OldFORTRANdog/GST_Arduino_Robotics/Documentation/B3_Documentation_2024.pdf

# BreadBoardBot

# Layout and wiring, rev. 2024d

6/4/2024

# B3 Top Layout: 3 large holes, 2 medium holes

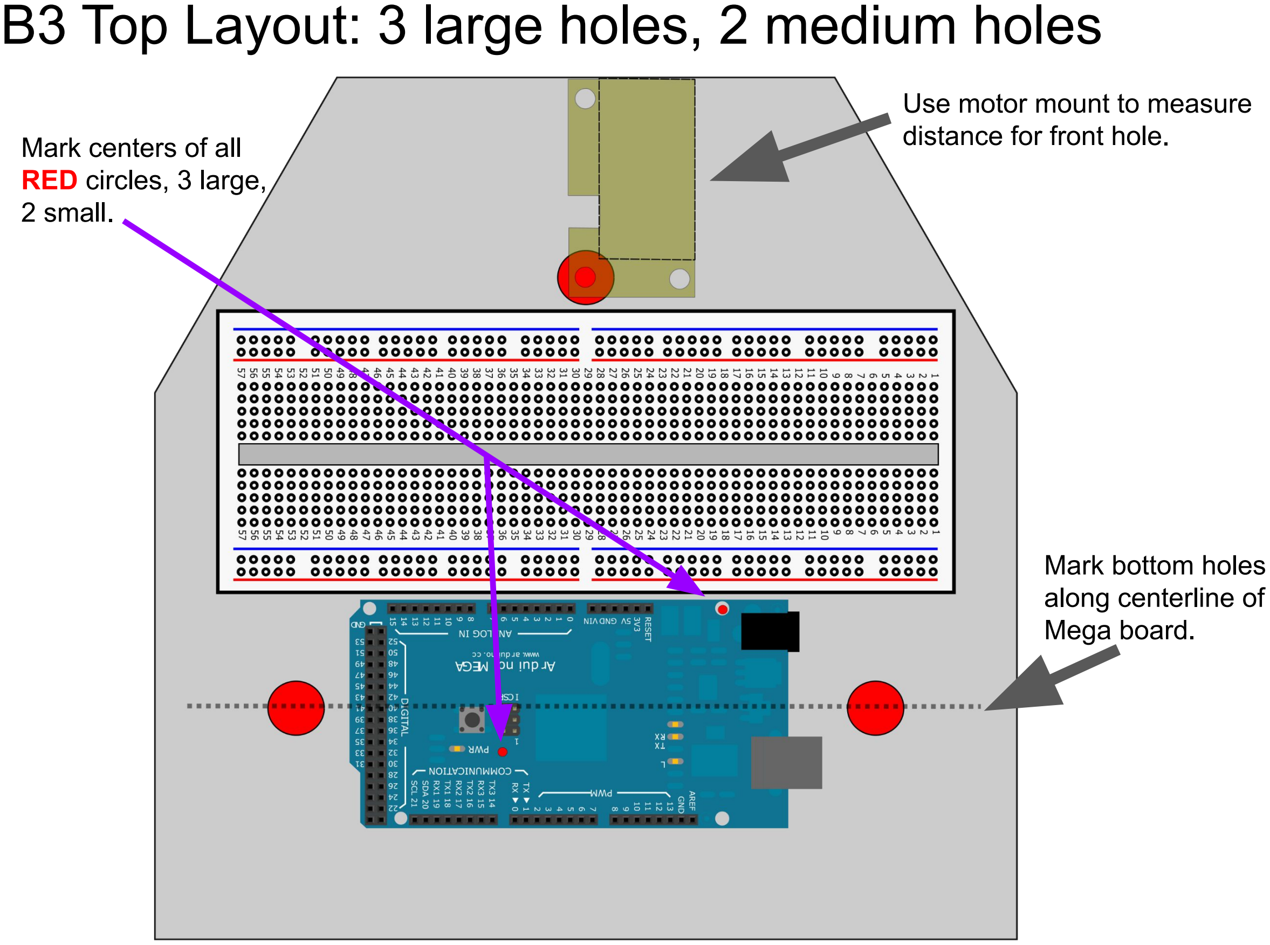
[picture p1: page 2]

| Use motor mount to measure distance for front hole.

Mark bottom holes
along centerline of
Mega board.

Mark centers of all
RED circles, 3 large,
2 small.

# B3 Bottom Layout 1: 6 medium holes, 4 small holes

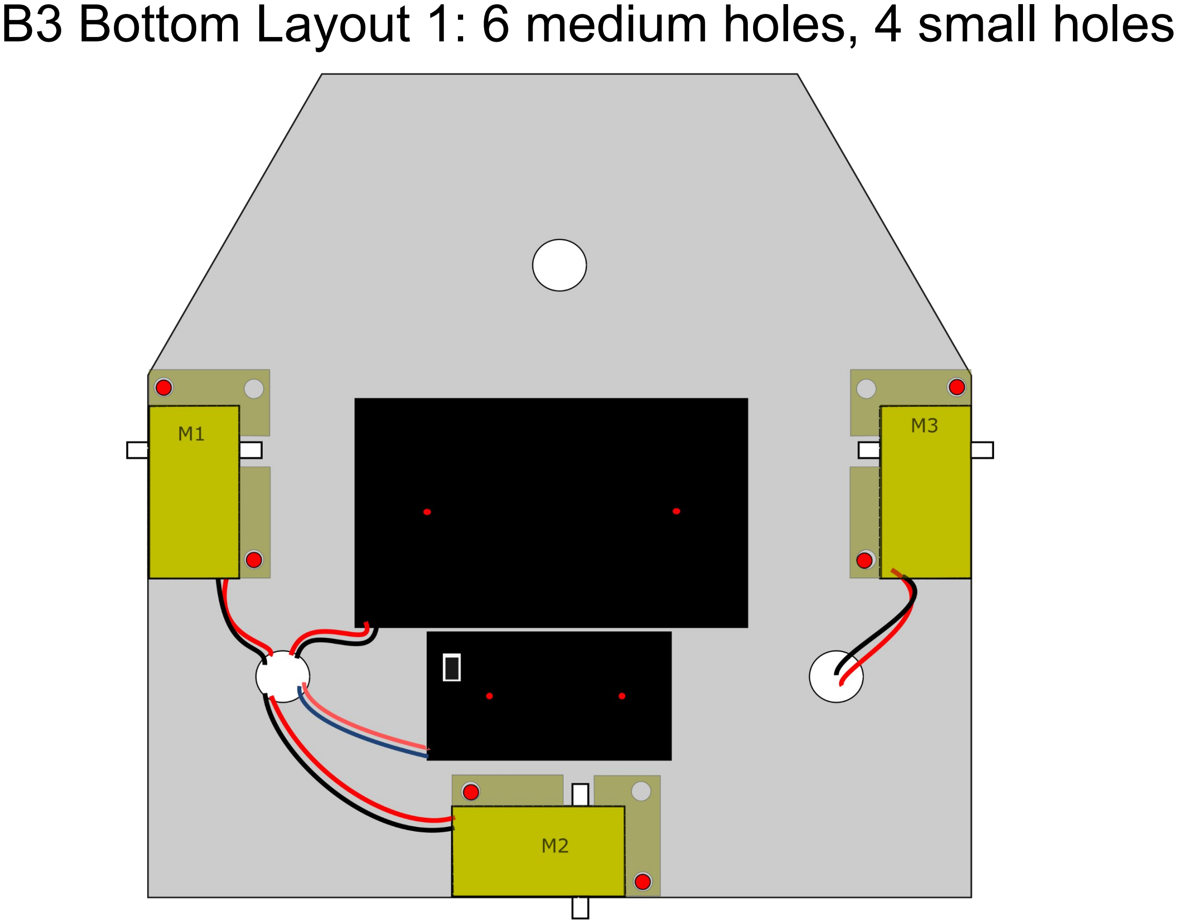
[picture p2: page 3]

# B3 Bottom Layout 2: 4 more medium holes

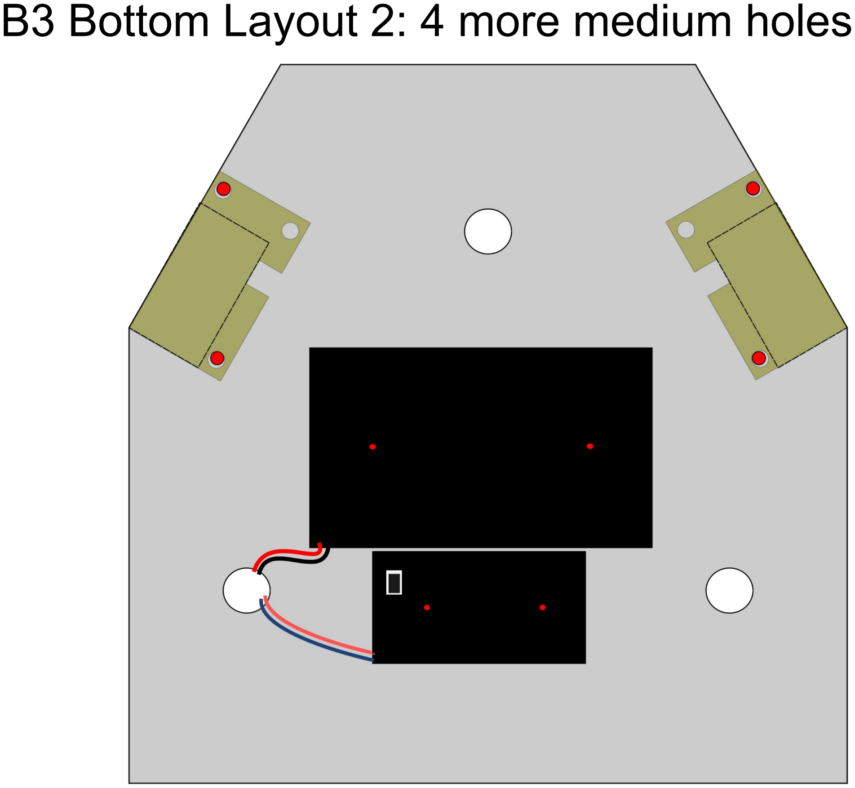
[picture p3: page 4]

Drill holes, then… | Omniwheel assembly (demo)
- Always wear safety glasses when
using the drills. This is
non-negotiable.
- Use medium sized bit for all motor mount holes (10 of those) and, HIGHLY SUGGESTED, to drill pilot holes for the ½” big holes (3 of those).
- Drill six small holes, 2 marked on front for the Mega, and 4 on the back for both battery holders.
- Drill the three big holes, which is much easier with pilot holes.
- Place motors into motor mounts. Make sure the stub on side of motor fits into hole on side of motor mounts.
- Using the small white tubes and the long small screws (3 of each, one set per motor), place the tube fully on the outside motor axle (the side away from the rim of the motor mount.)
- Drill small hole through axle and tube and secure tube in place with screw.
- Get omniwheels (3) and the largest screws. Put a small amount of hot glue on the tube, push omni wheel over tube, and screw large screw into tube to expand the tube and provide grip for the wheel.

# B3 Begin Assembly (shield demo)

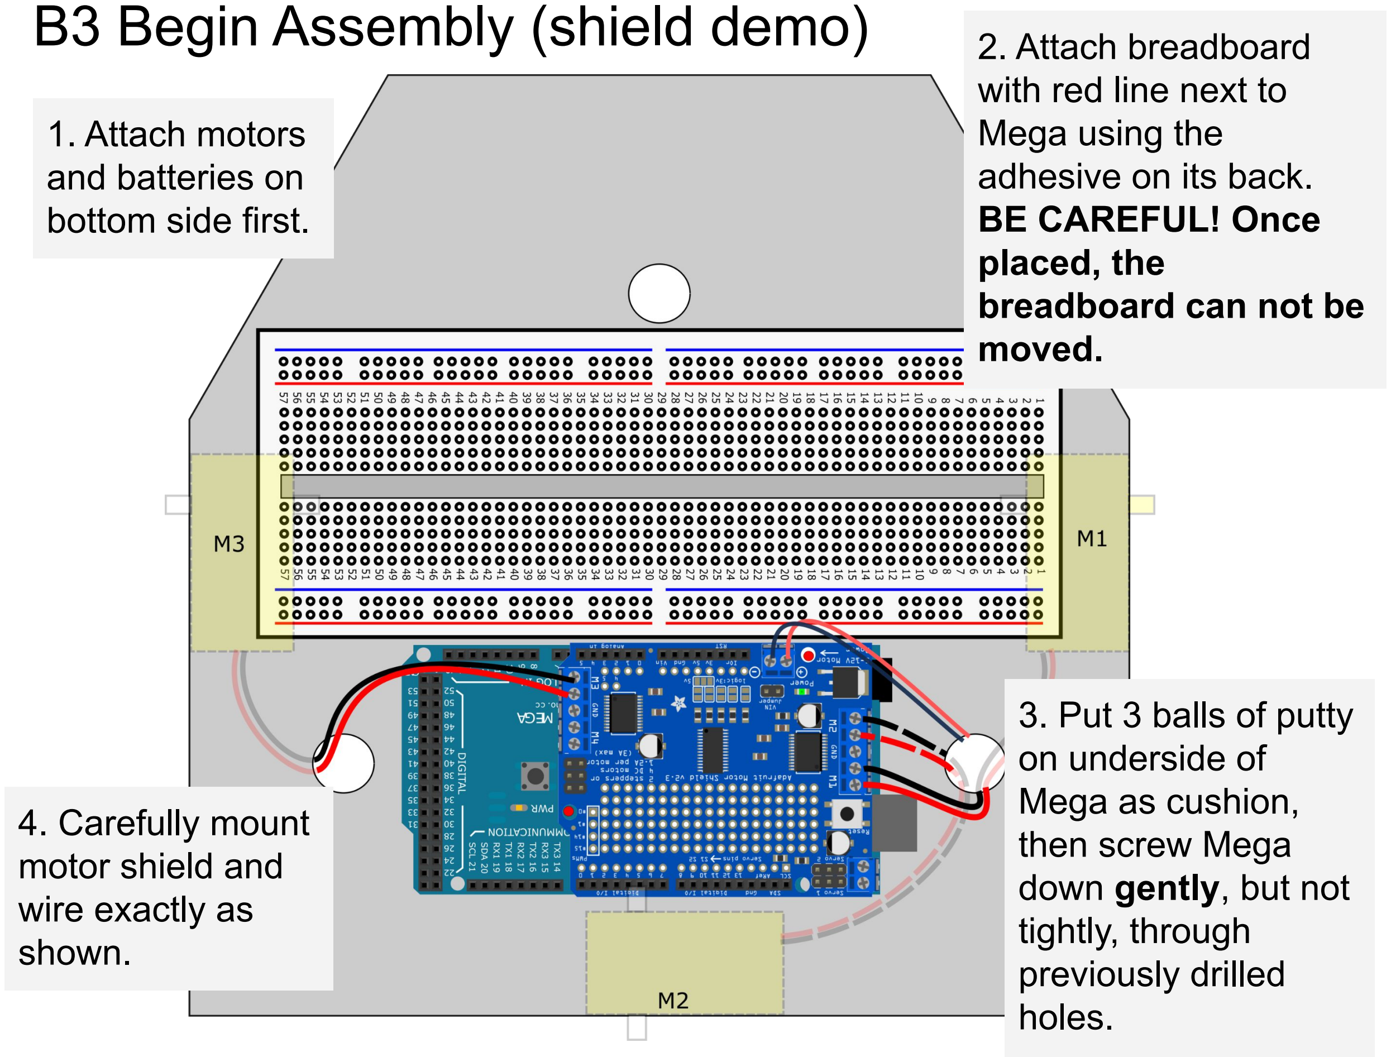
[picture p4: page 6]

1. Attach motors
and batteries on
bottom side first.
2. Attach breadboard
with red line next to
Mega using the
adhesive on its back.
BE CAREFUL! Once
placed, the
breadboard can not be
moved.
3. Put 3 balls of putty
on underside of
Mega as cushion,
then screw Mega
down gently, but not
tightly, through
previously drilled
holes.
4. Carefully mount
motor shield and
wire exactly as
shown.

# B3 Power and Ground Circuits

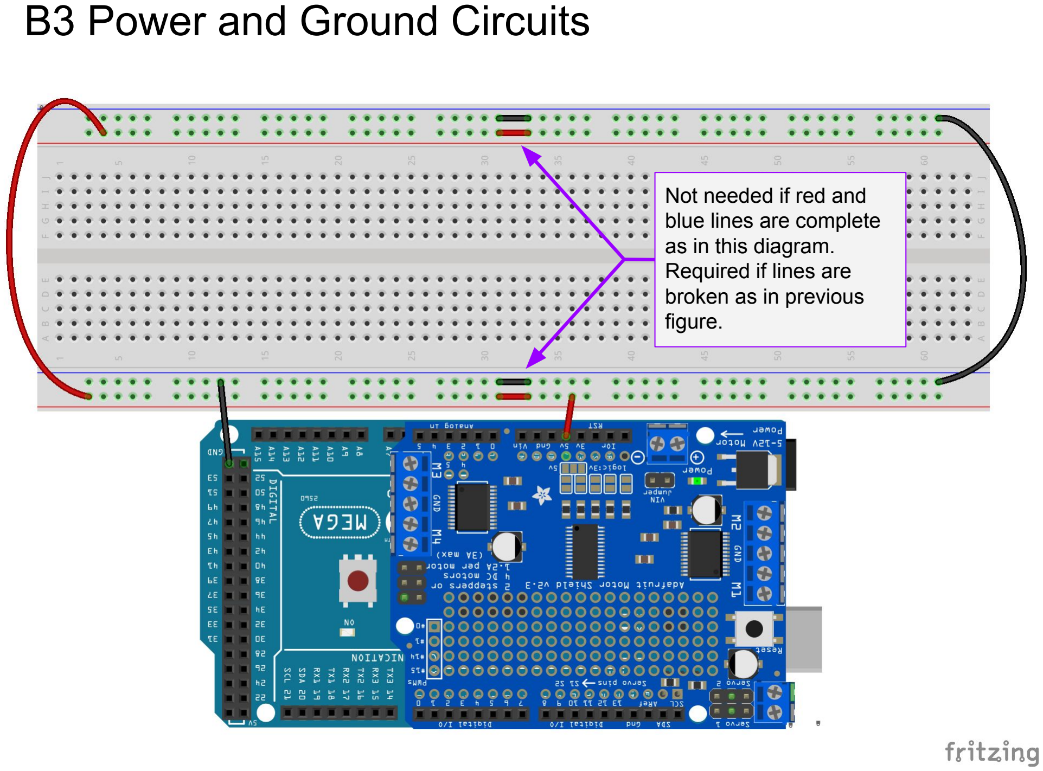
[picture p5: page 7]

Not needed if red and
blue lines are complete
as in this diagram.
Required if lines are
broken as in previous
figure.

# B3 Blink Circuits

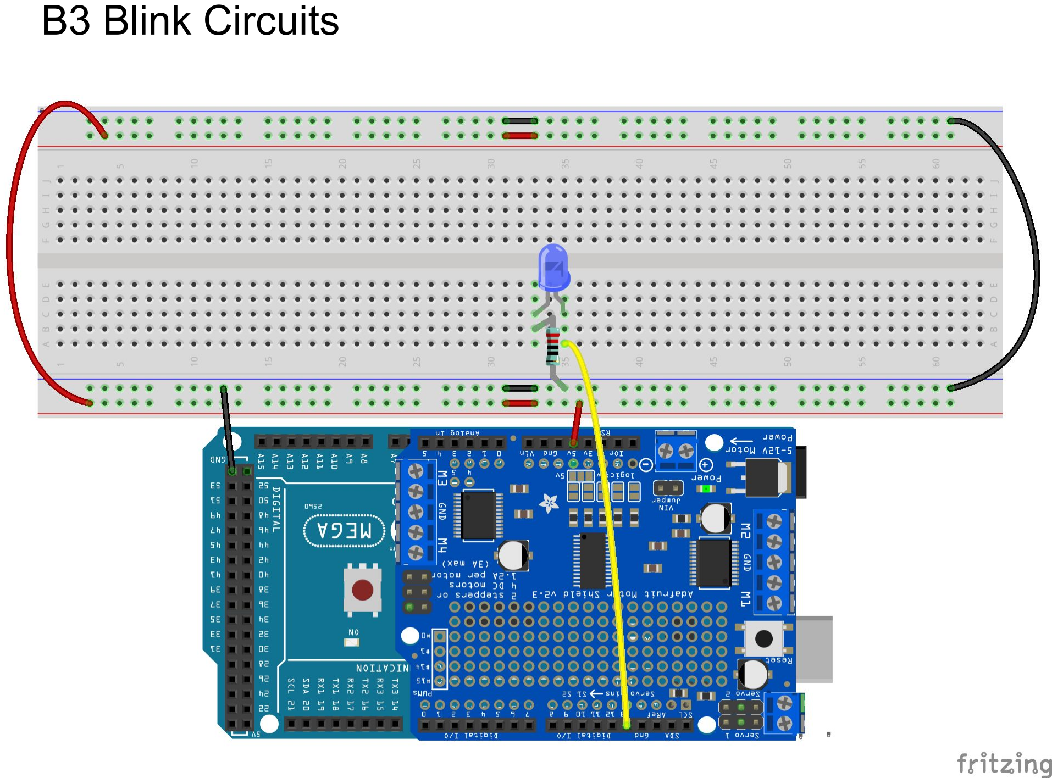
[picture p6: page 8]

# B3 Blink & Bump Circuits

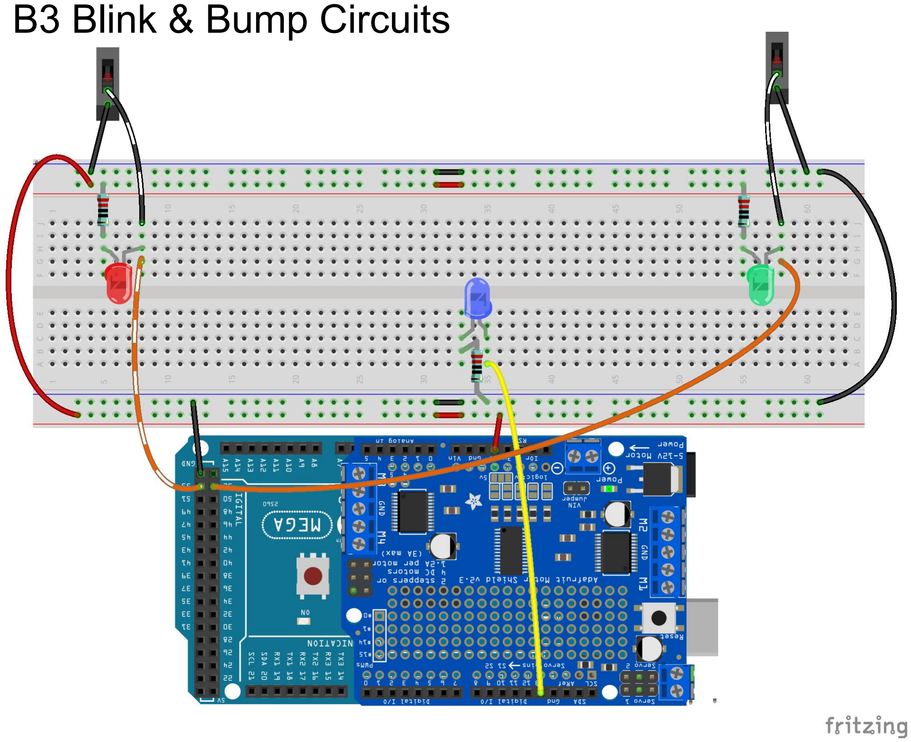
[picture p7: page 9]

# B3 Blink, Bump & Light Detection Circuits

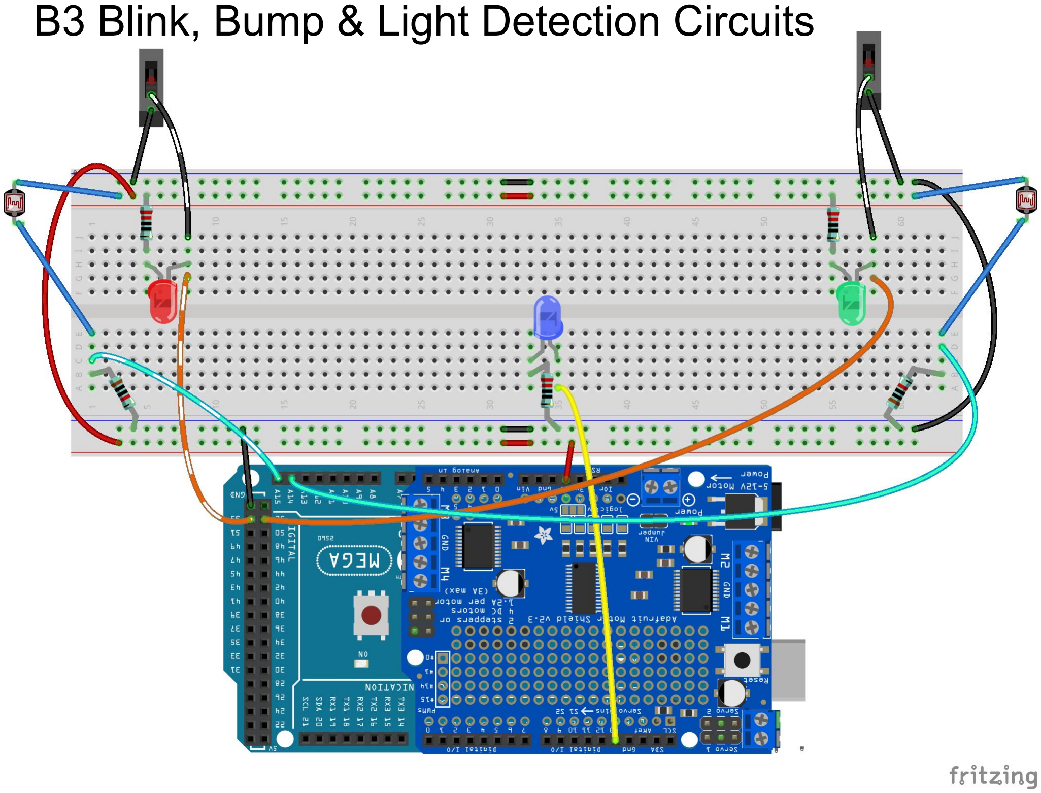
[picture p8: page 10]

# B3 Blink, Bump, Light & IR Circuits

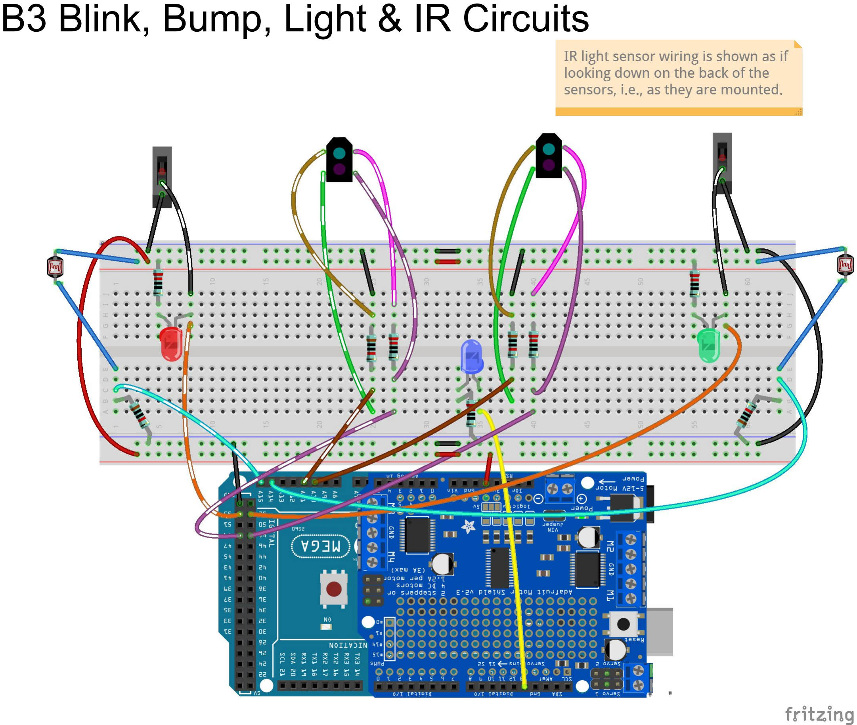
[picture p9: page 11]

# B3 Blink, Bump, Light, IR, Sonic & Servo Circuits

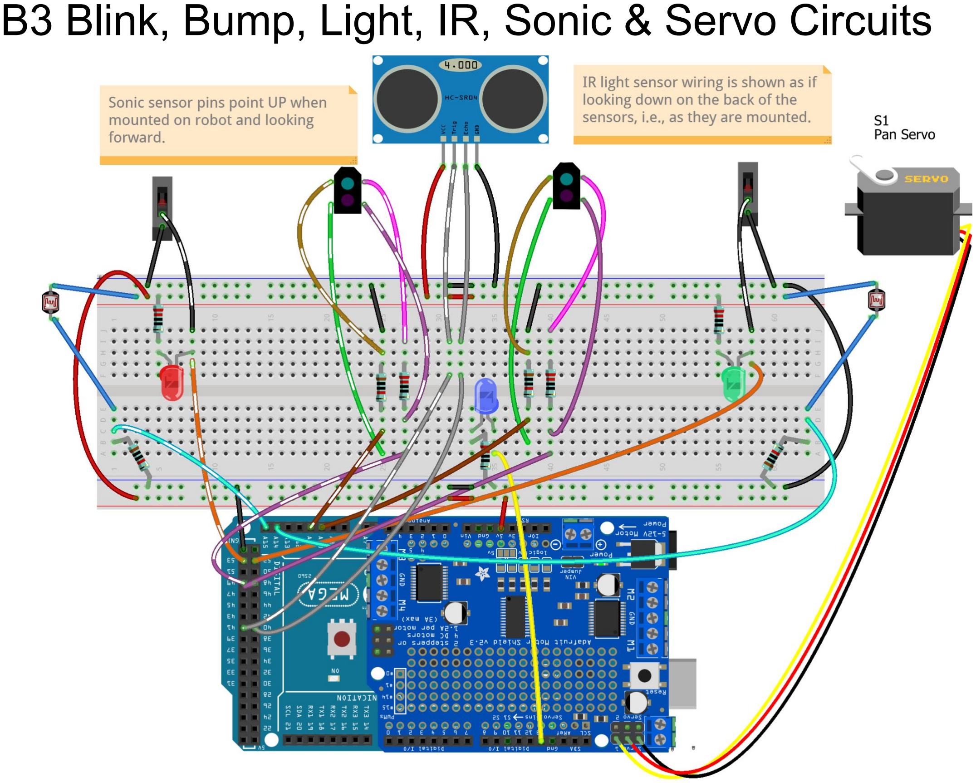
[picture p10: page 12]

# B3 Bonus Circuits

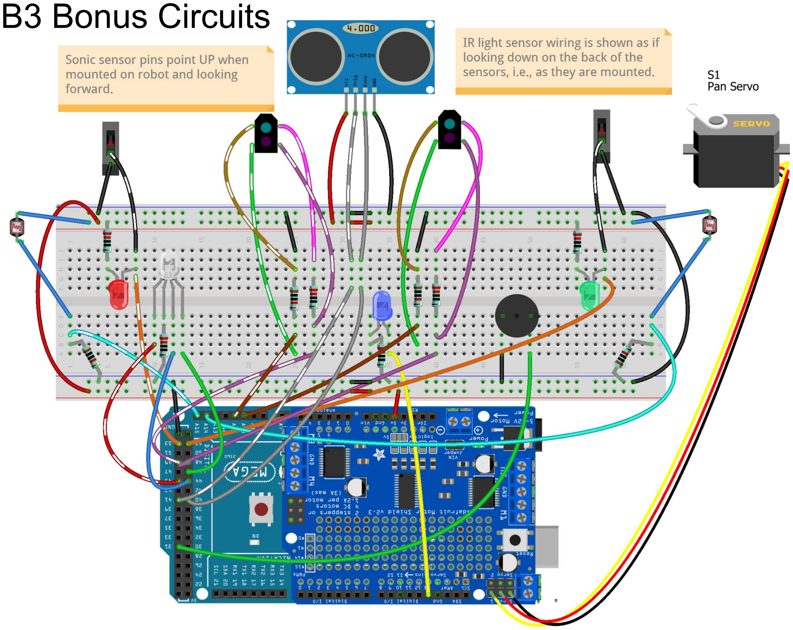
[picture p11: page 13]
