OldFORTRANdog/GST_Arduino_Robotics/2022GST/B3_Documentation_2022.pdf

# BreadBoardBot

Layout and wiring, 2022

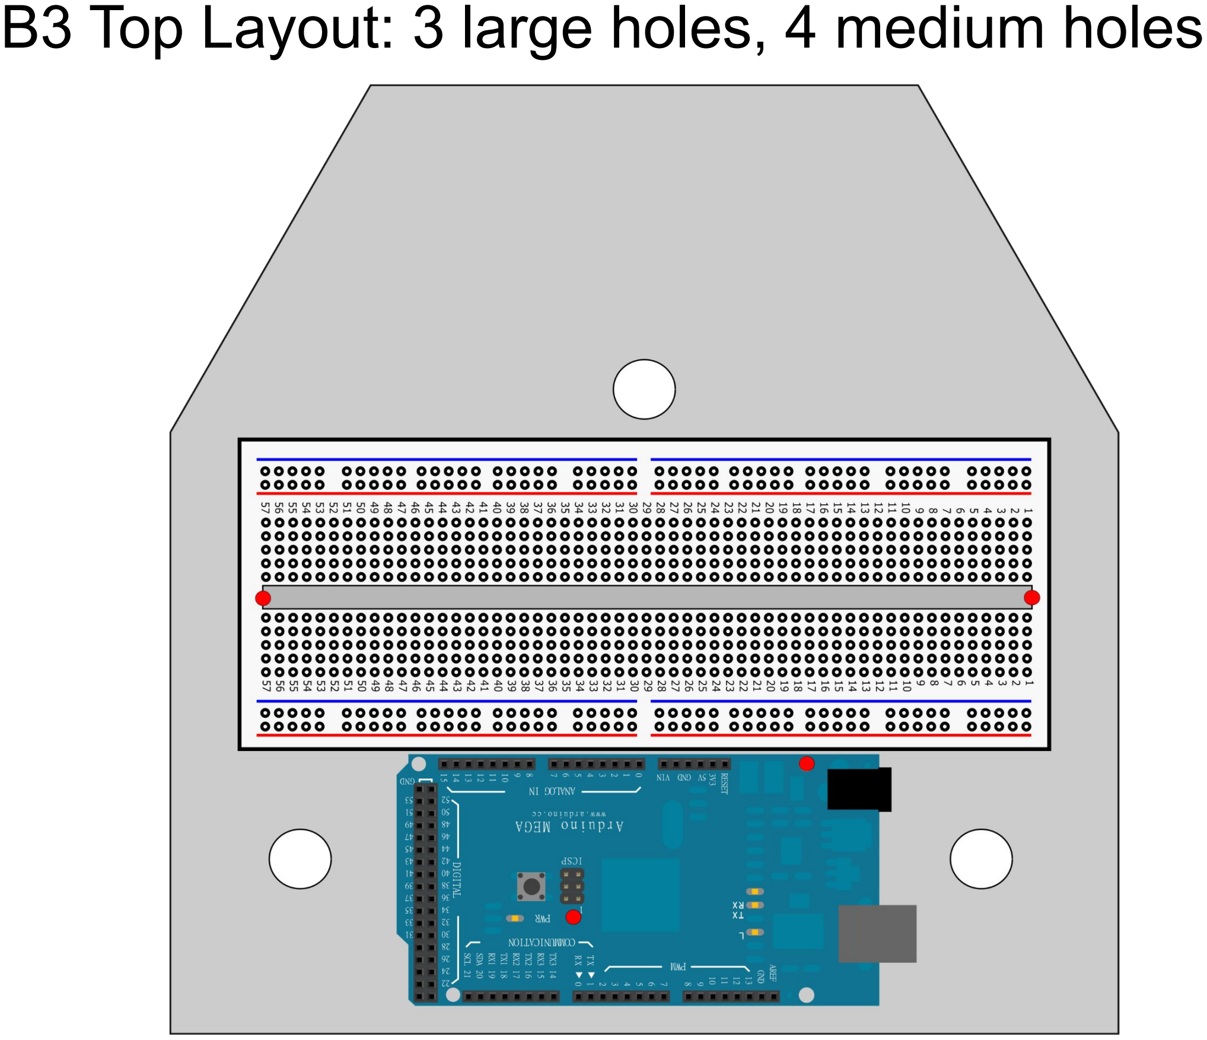
[picture p12: page 2]

B3 Top Layout: 3 large holes, 4 medium holes

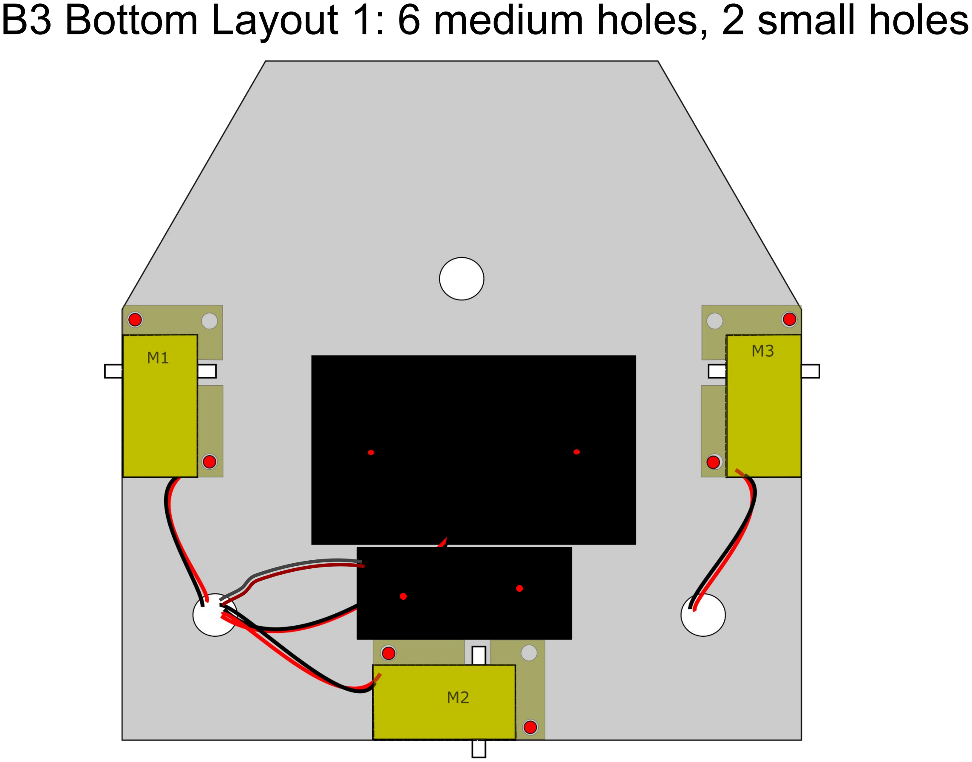
[picture p13: page 3]

B3 Bottom Layout 1: 6 medium holes, 2 small holes

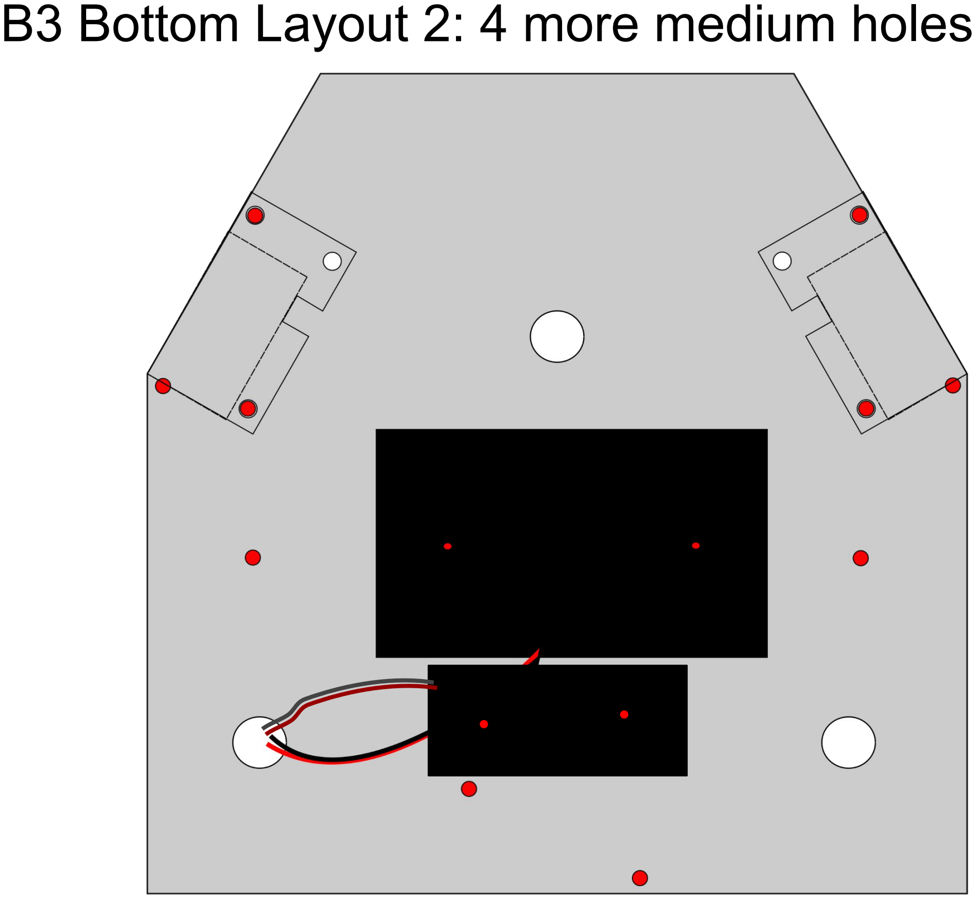
[picture p14: page 4]

B3 Bottom Layout 2: 4 more medium holes

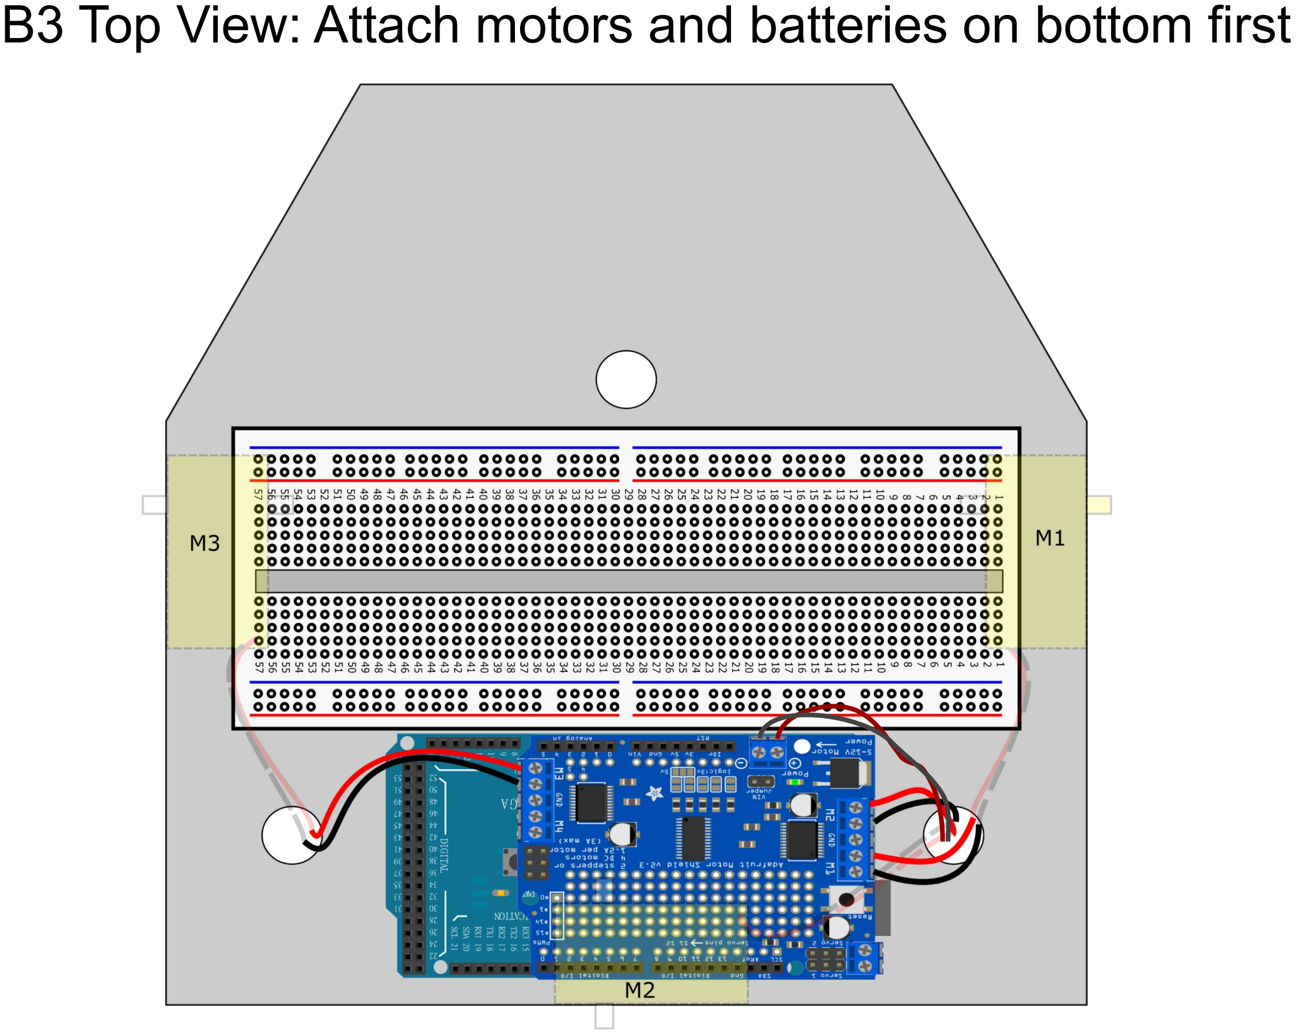
[picture p15: page 5]

B3 Top View: Attach motors and batteries on bottom first

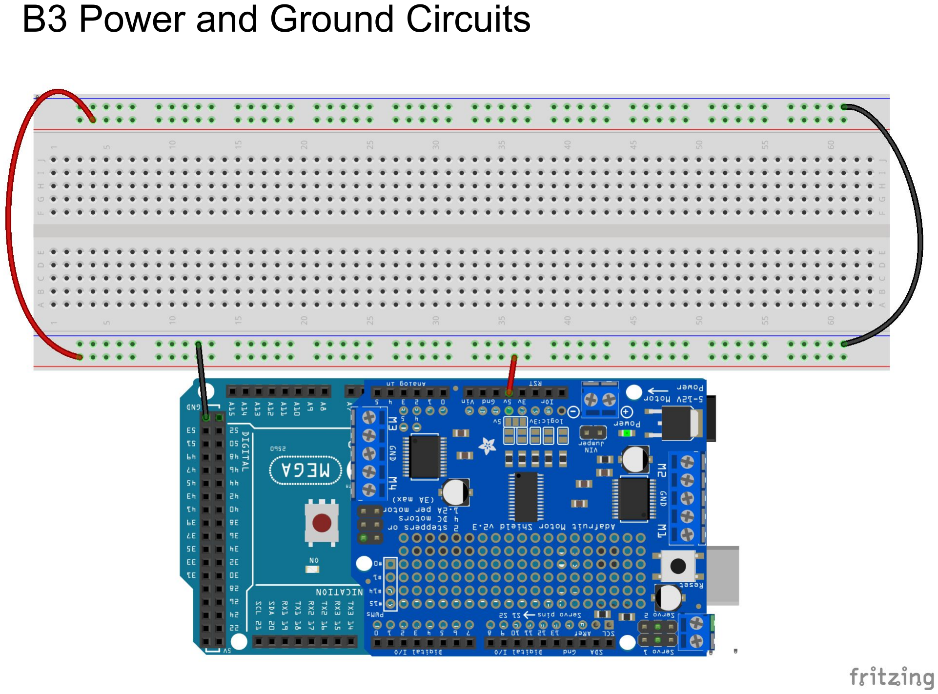
[picture p16: page 6]

B3 Power and Ground Circuits

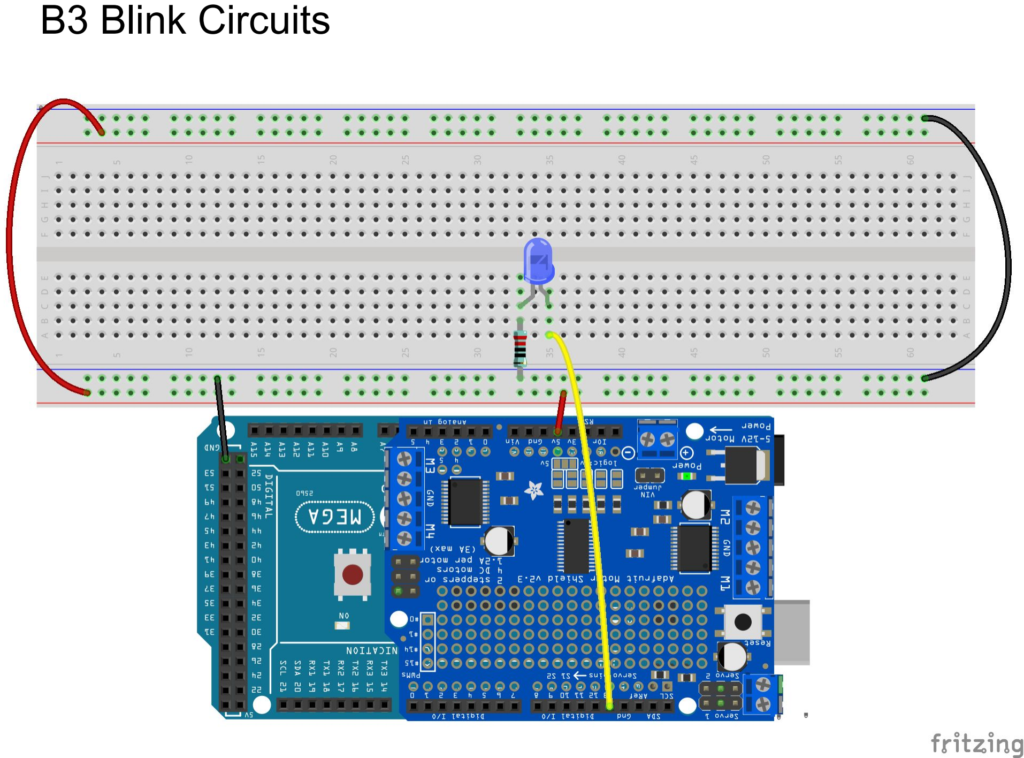
[picture p17: page 7]

B3 Blink Circuits

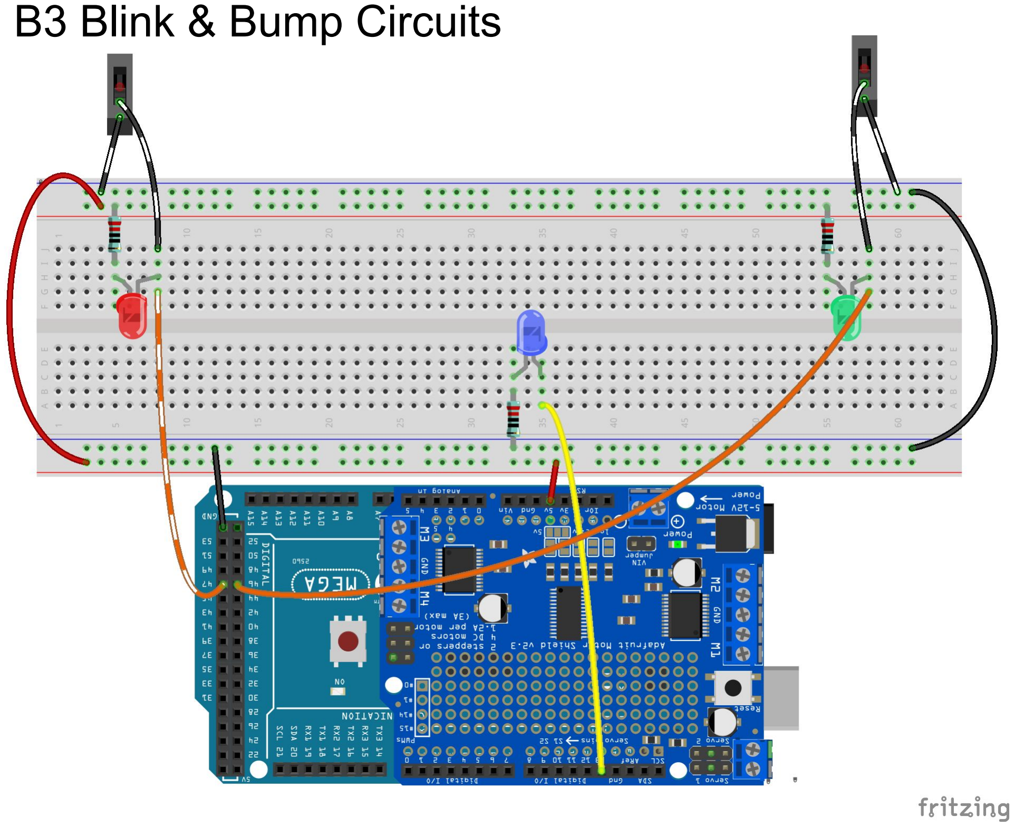
[picture p18: page 8]

B3 Blink & Bump Circuits

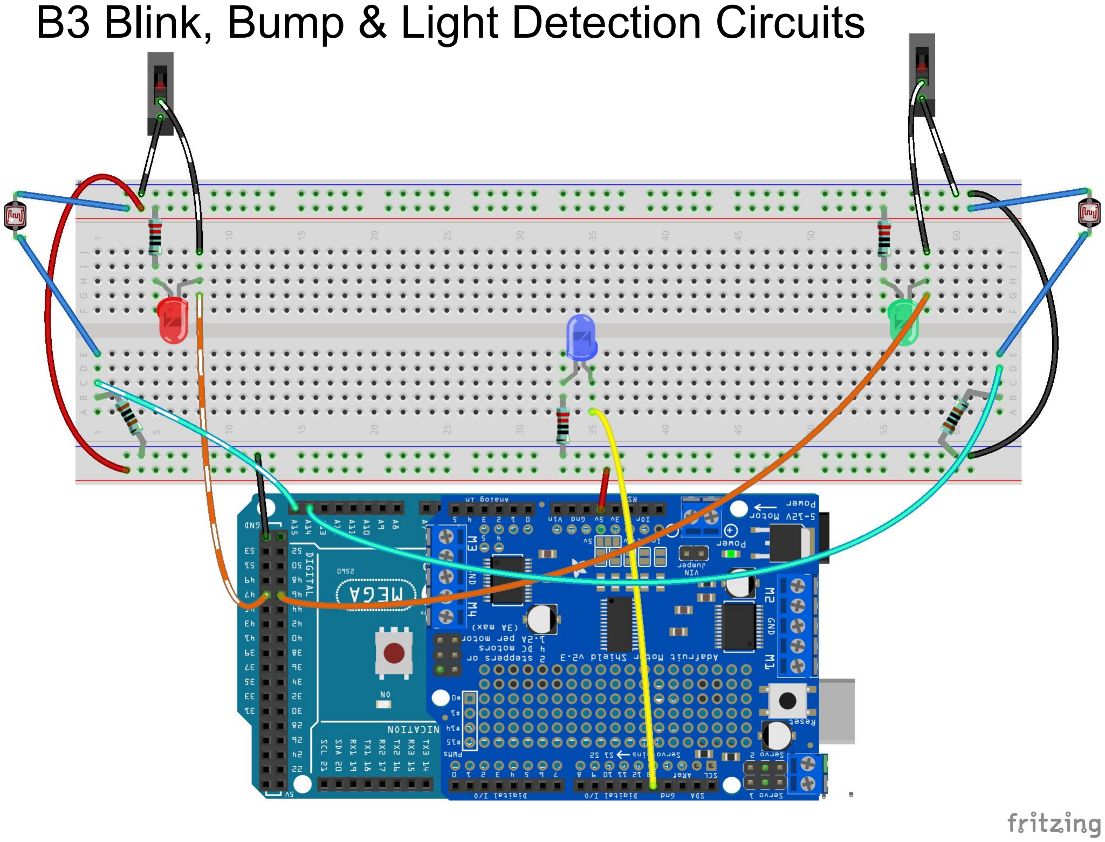
[picture p19: page 9]

B3 Blink, Bump & Light Detection Circuits

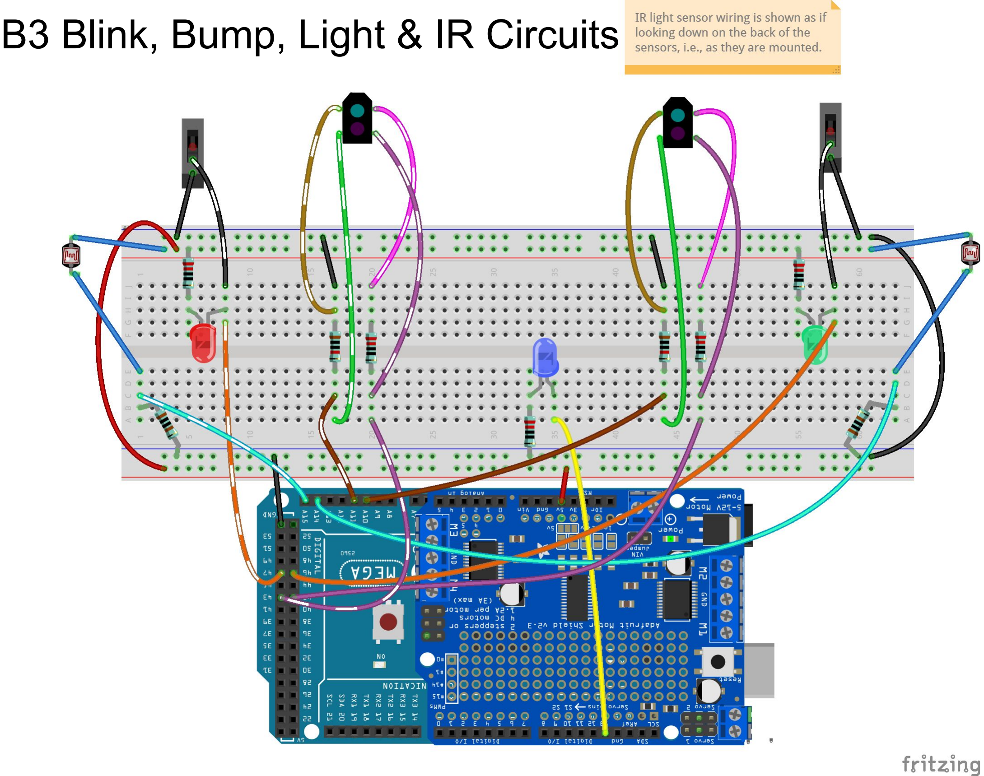
[picture p20: page 10]

B3 Blink, Bump, Light & IR Circuits

X

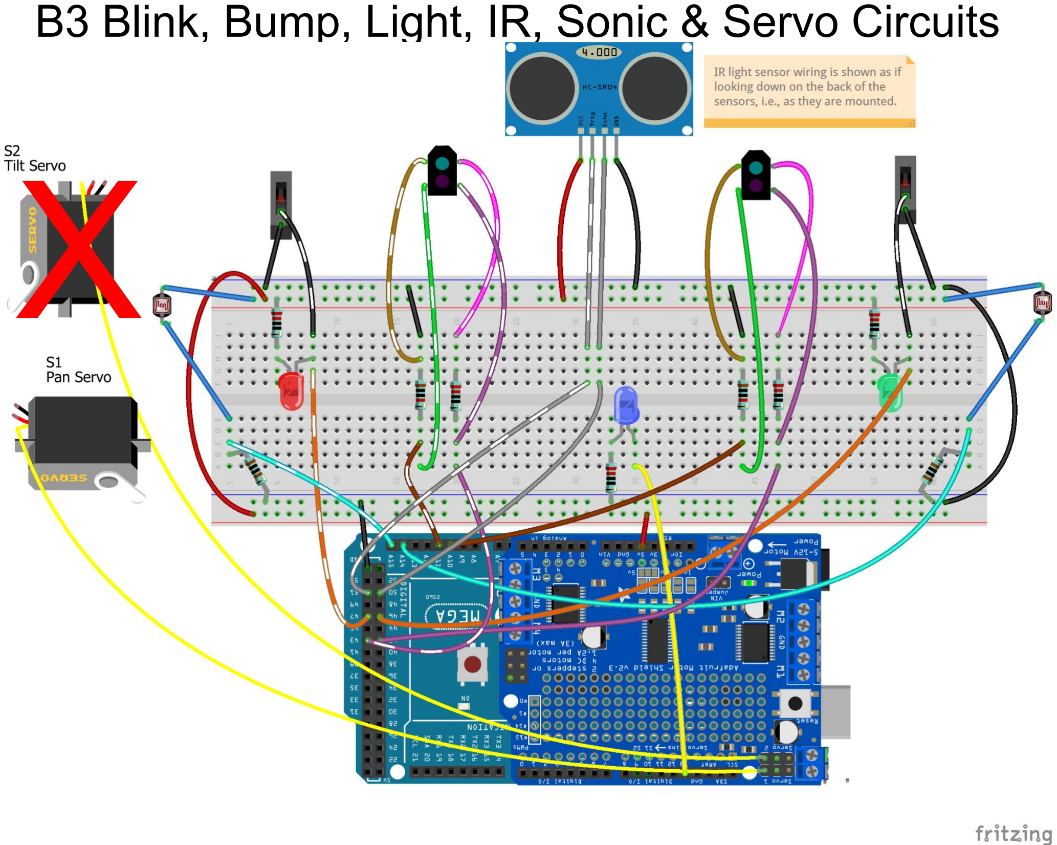
[picture p21: page 11]

B3 Blink, Bump, Light, IR, Sonic & Servo Circuits

X

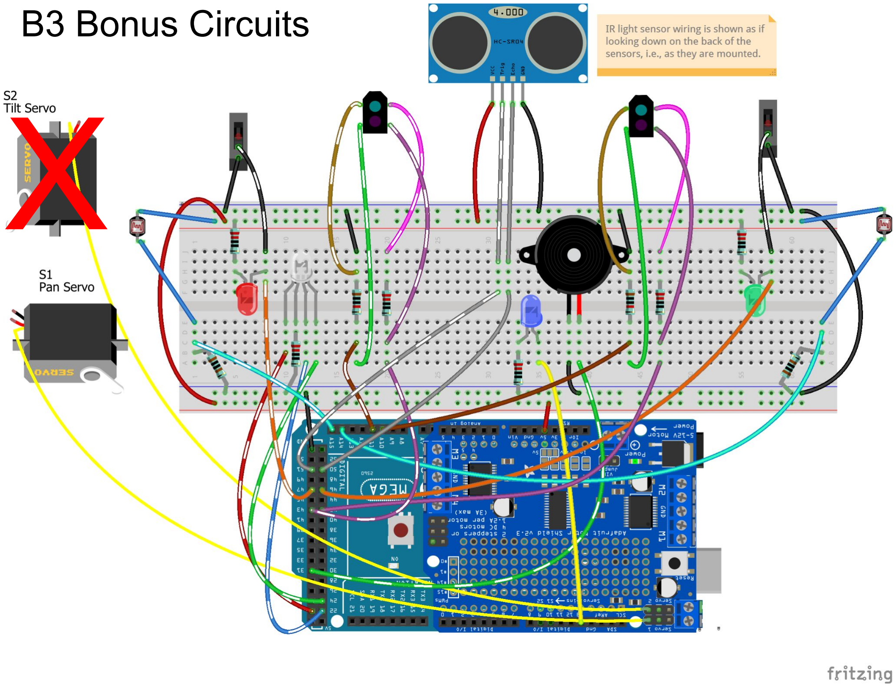
[picture p22: page 12]

B3 Bonus Circuits
