OldFORTRANdog/GST_Arduino_Robotics/Documentation/2023/B3_Documentation_2023.pdf

# BreadBoardBot

Layout and wiring, 2023

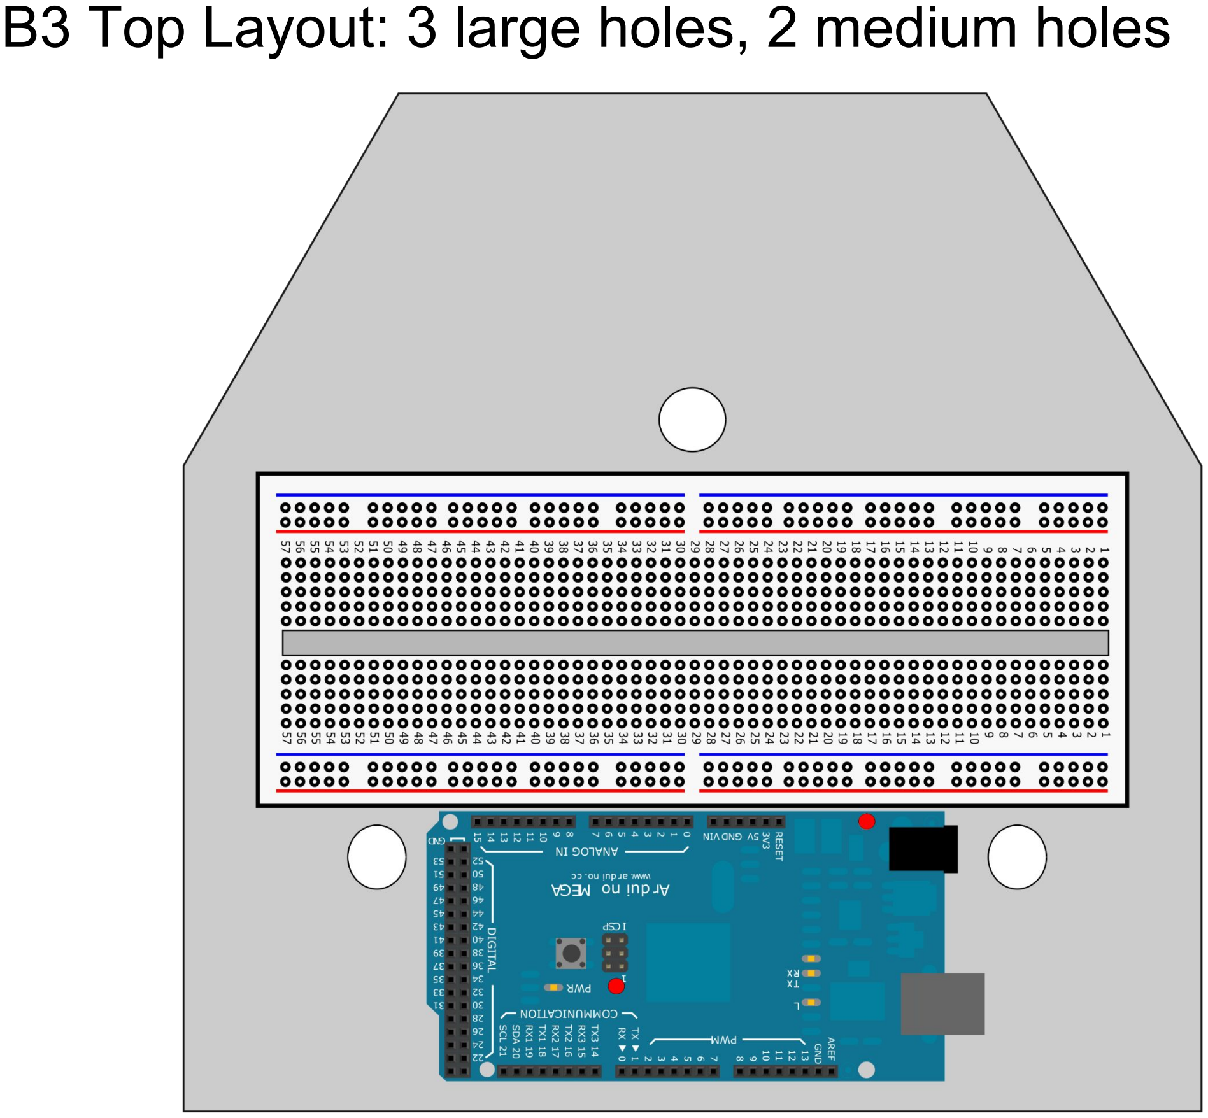
[picture p26: page 2]

B3 Top Layout: 3 large holes, 2 medium holes

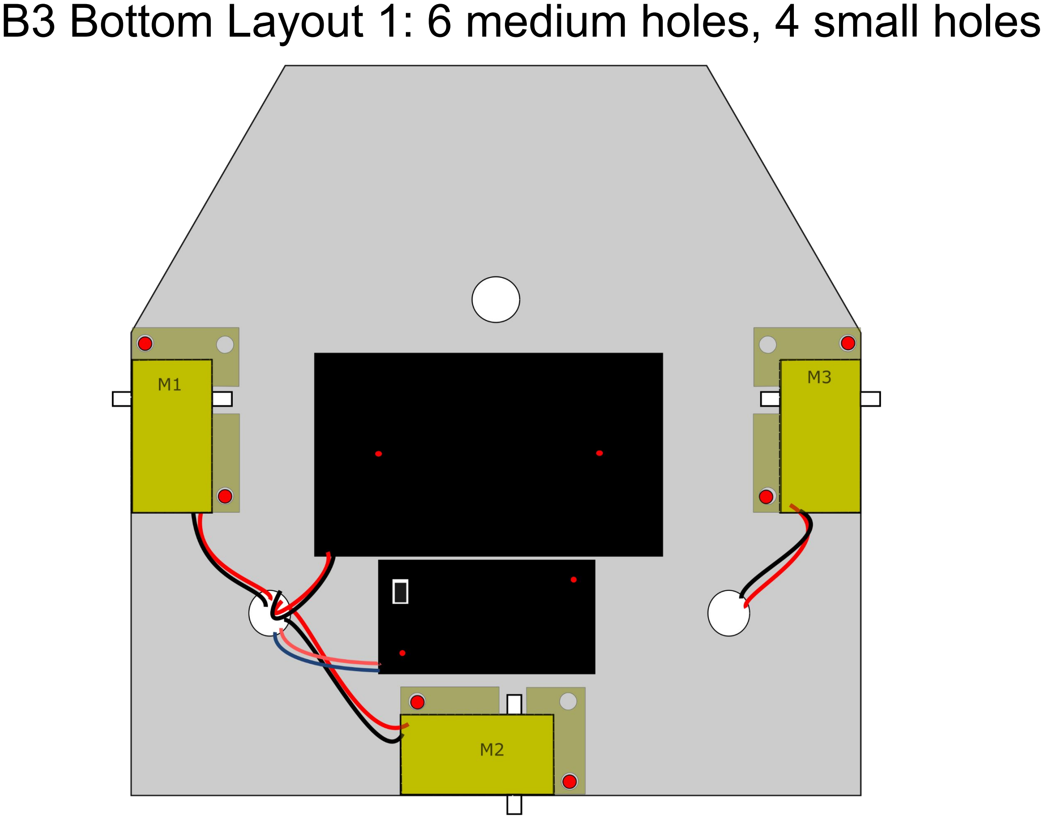
[picture p27: page 3]

B3 Bottom Layout 1: 6 medium holes, 4 small holes

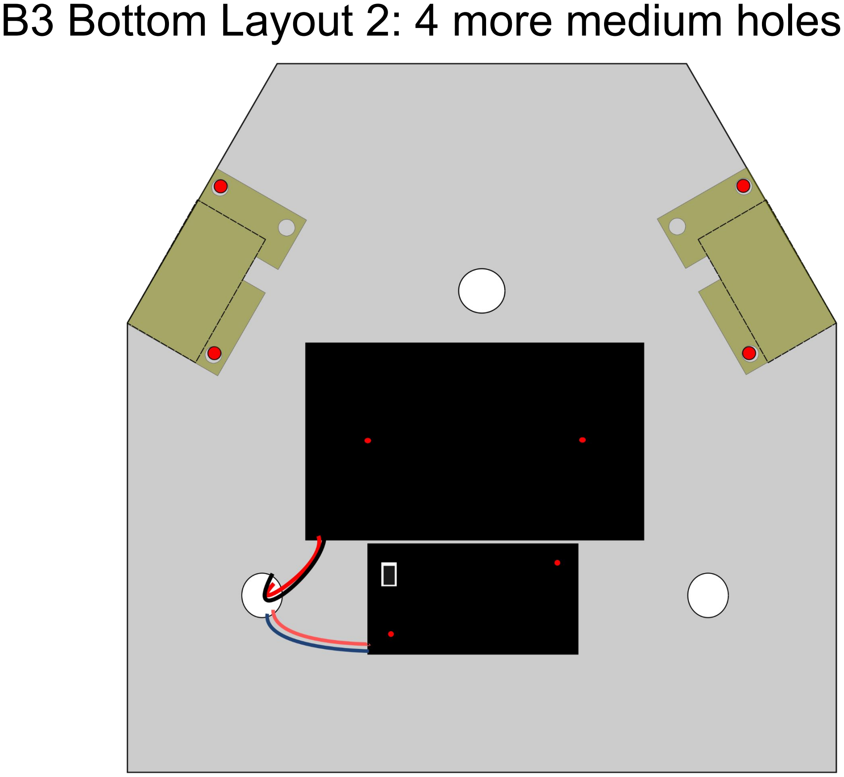
[picture p28: page 4]

B3 Bottom Layout 2: 4 more medium holes

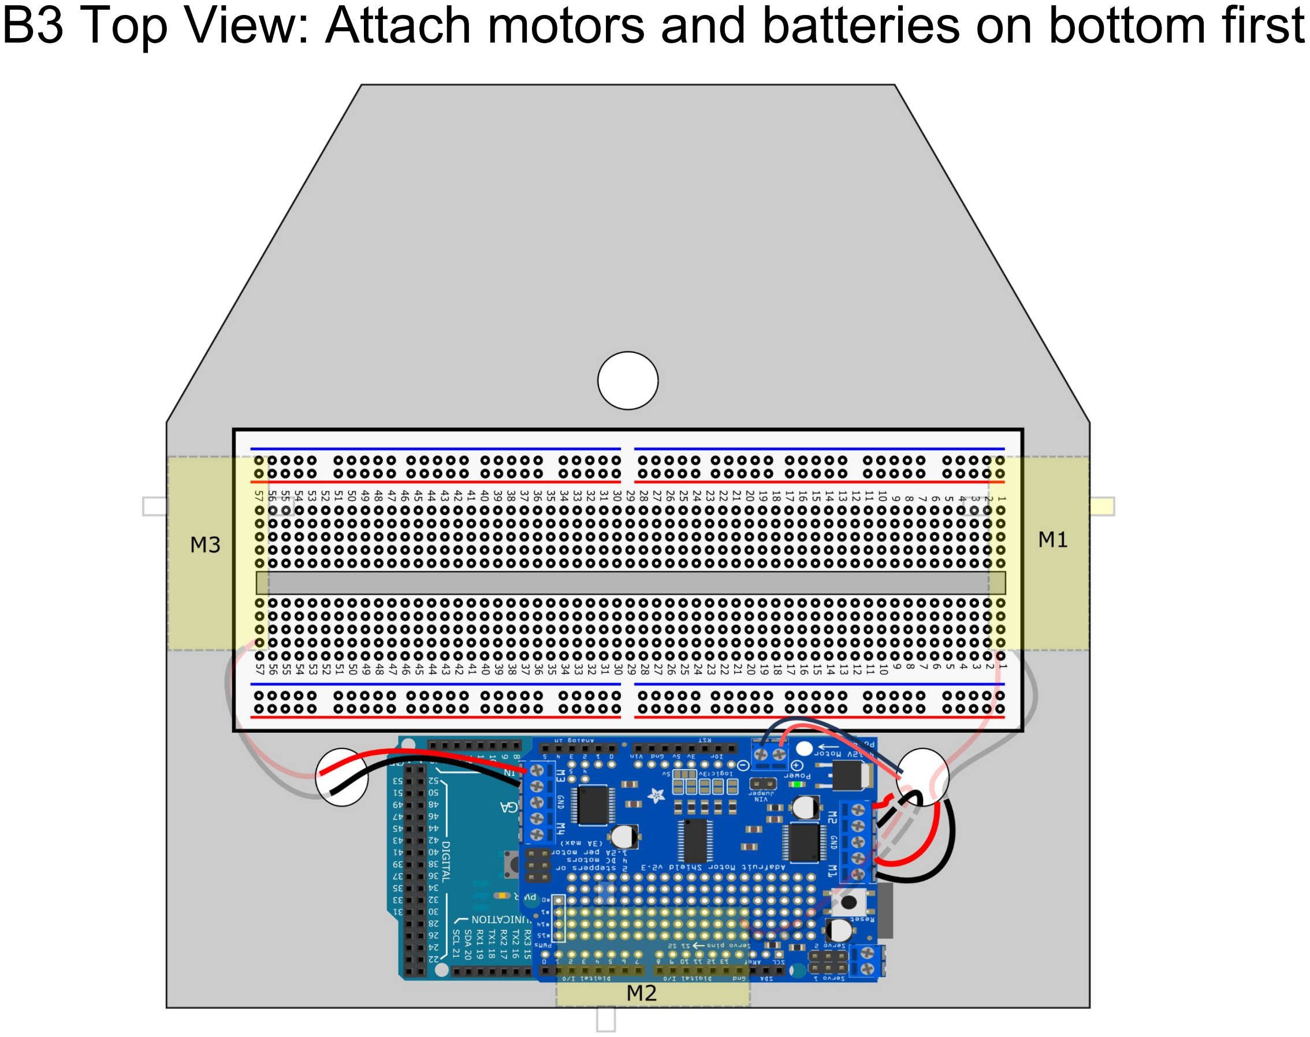
[picture p29: page 5]

B3 Top View: Attach motors and batteries on bottom first


B3 Power and Ground Circuits


B3 Blink Circuits


B3 Blink & Bump Circuits


B3 Blink, Bump & Light Detection Circuits


B3 Blink, Bump, Light & IR Circuits

X


B3 Blink, Bump, Light, IR, Sonic & Servo Circuits

X


B3 Bonus Circuits
