OldFORTRANdog/GST_Arduino_Robotics/Documentation/2021/B3_Documentation_2021.pdf

# BreadBoardBot

Layout and wiring, 2021


B3 Top Layout: 3 large holes, 4 medium holes

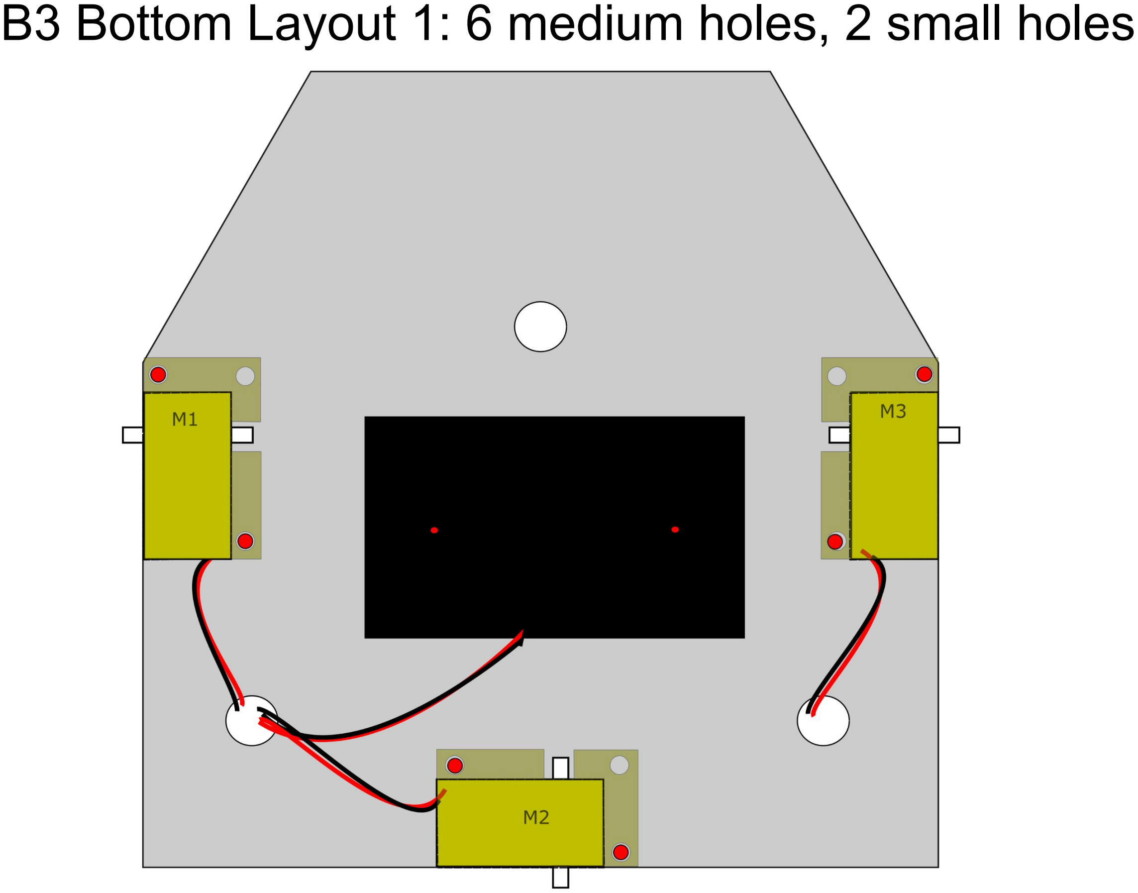
[picture p30: page 3]

B3 Bottom Layout 1: 6 medium holes, 2 small holes

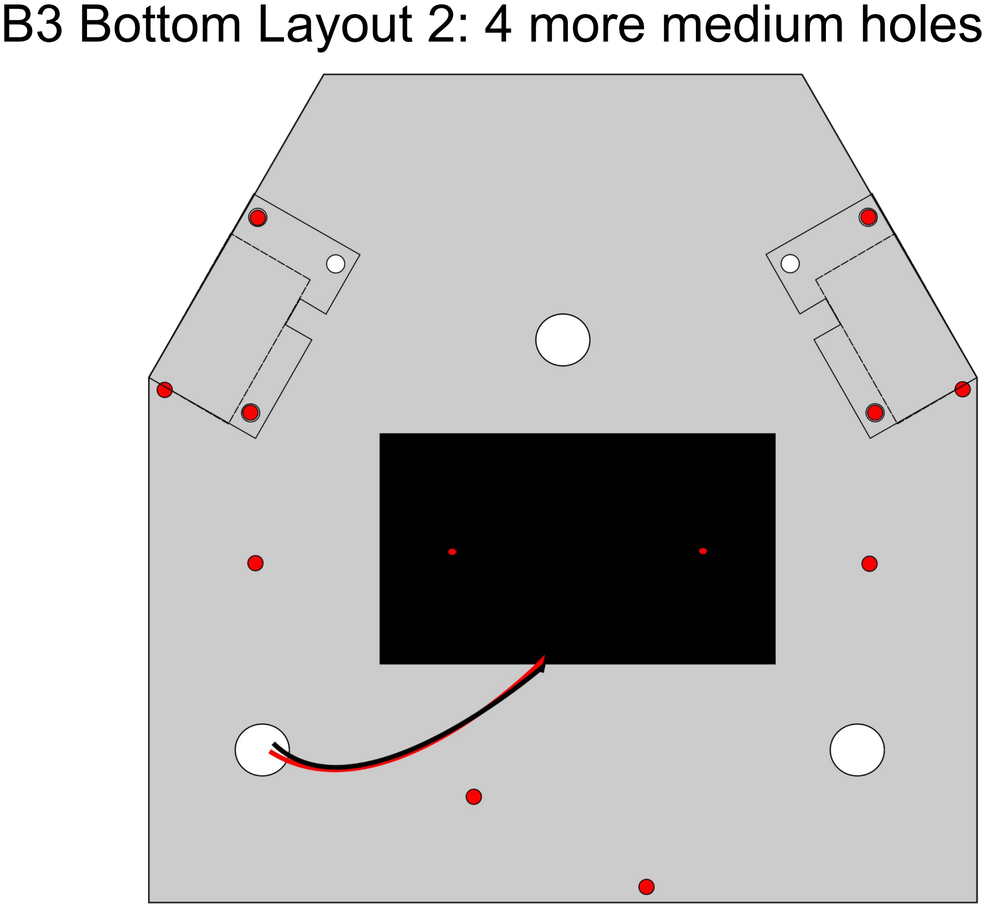
[picture p31: page 4]

B3 Bottom Layout 2: 4 more medium holes

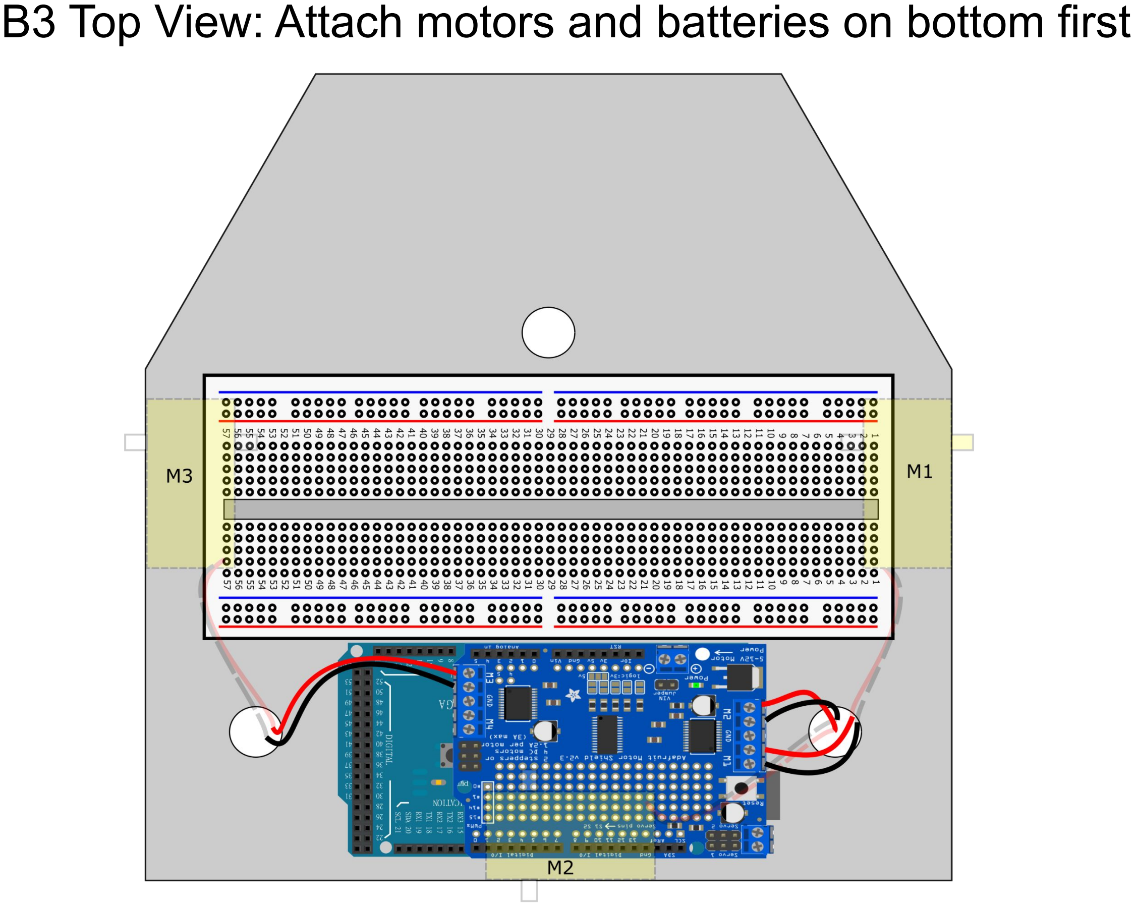
[picture p32: page 5]

B3 Top View: Attach motors and batteries on bottom first


B3 Power and Ground Circuits


B3 Blink Circuits


B3 Blink & Bump Circuits


B3 Blink, Bump & Light Detection Circuits


B3 Blink, Bump, Light & IR Circuits

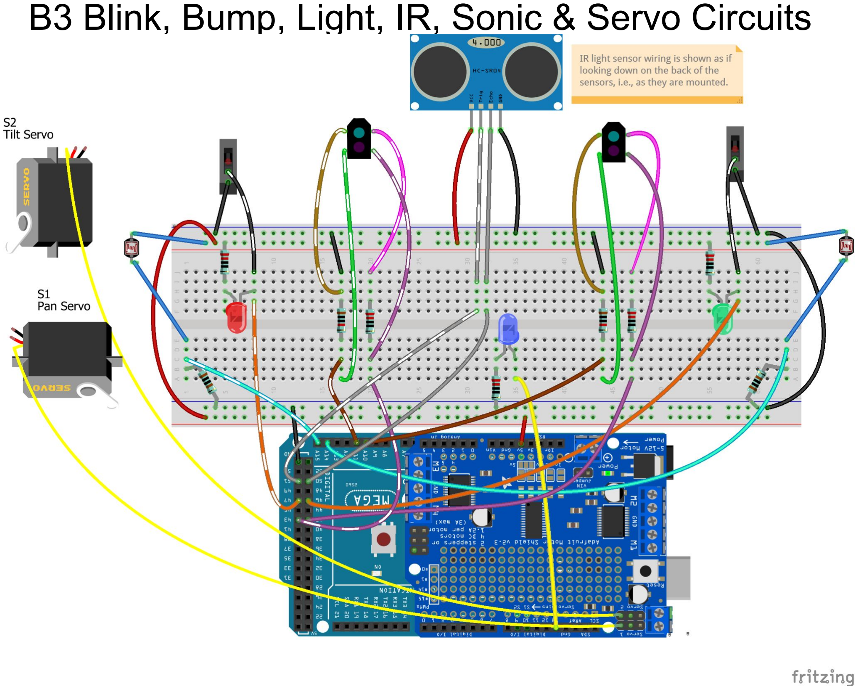
[picture p33: page 11]

B3 Blink, Bump, Light, IR, Sonic & Servo Circuits

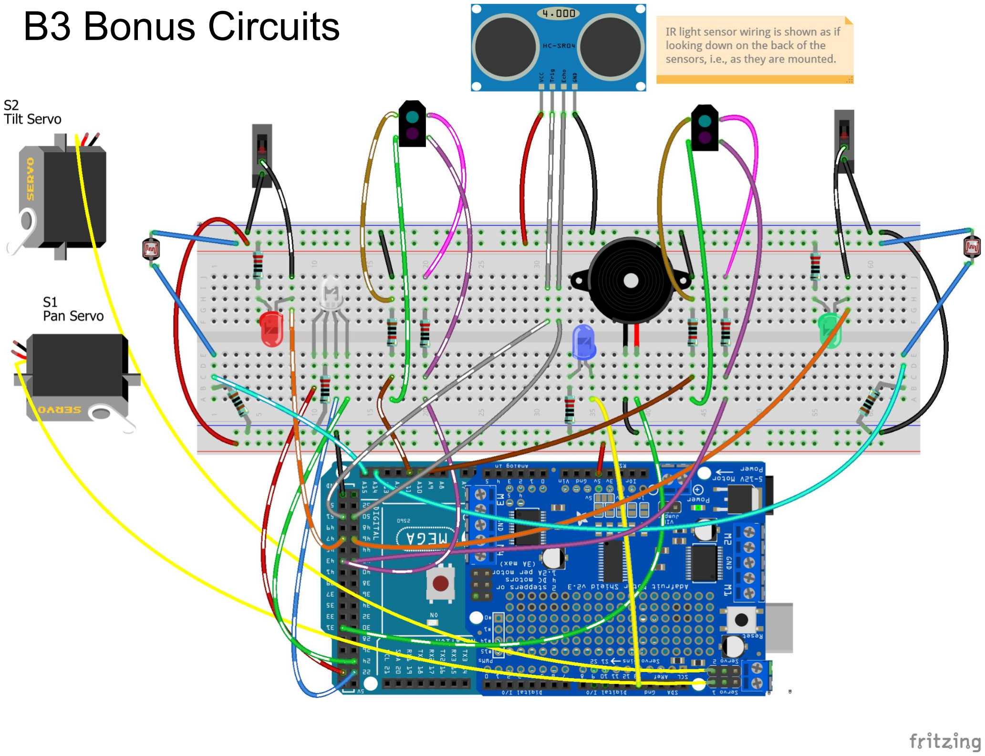
[picture p34: page 12]

B3 Bonus Circuits
