OldFORTRANdog/GST_Arduino_Robotics/2019GSTWk3/B3_Documentation/B3_BlinkBumpLightIRSonicServos2017_bb.png

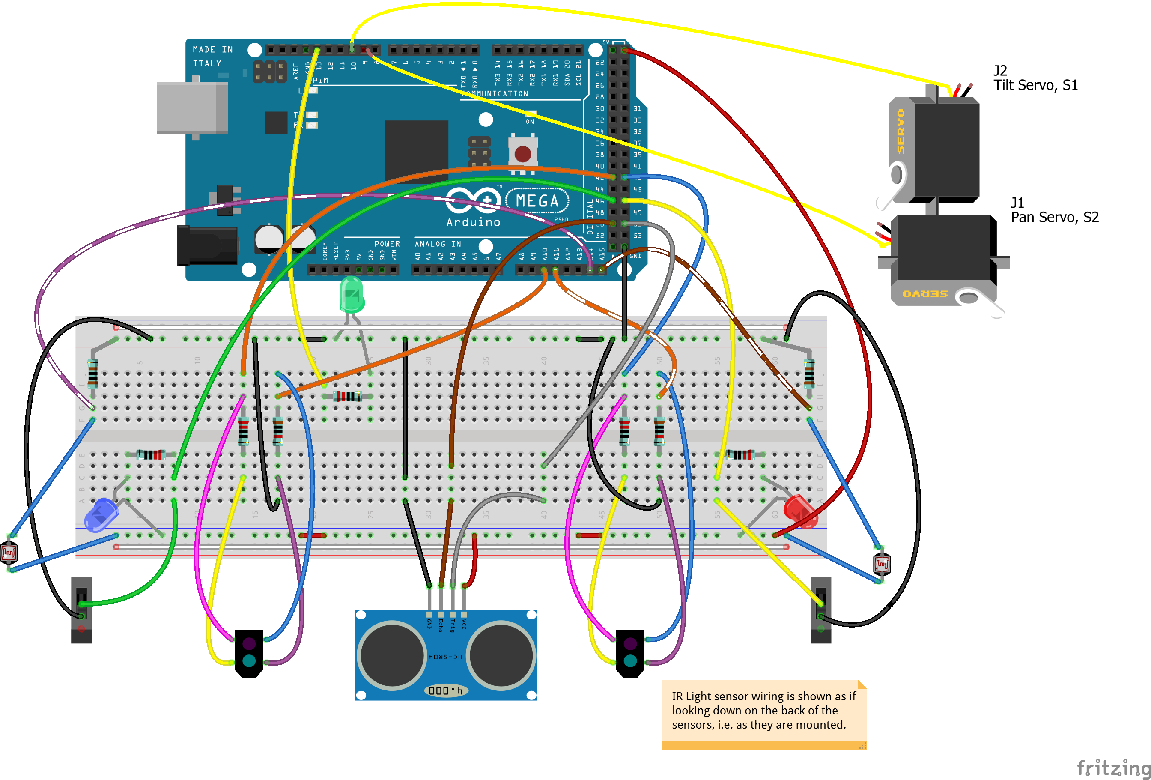
2019GSTWk3/B3_Documentation/B3_BlinkBumpLightIRSonicServos2017_bb.png
