OldFORTRANdog/GST_Arduino_Robotics/2019GSTWk3/B3_Documentation/B3_Chassis_Layout_Top.png

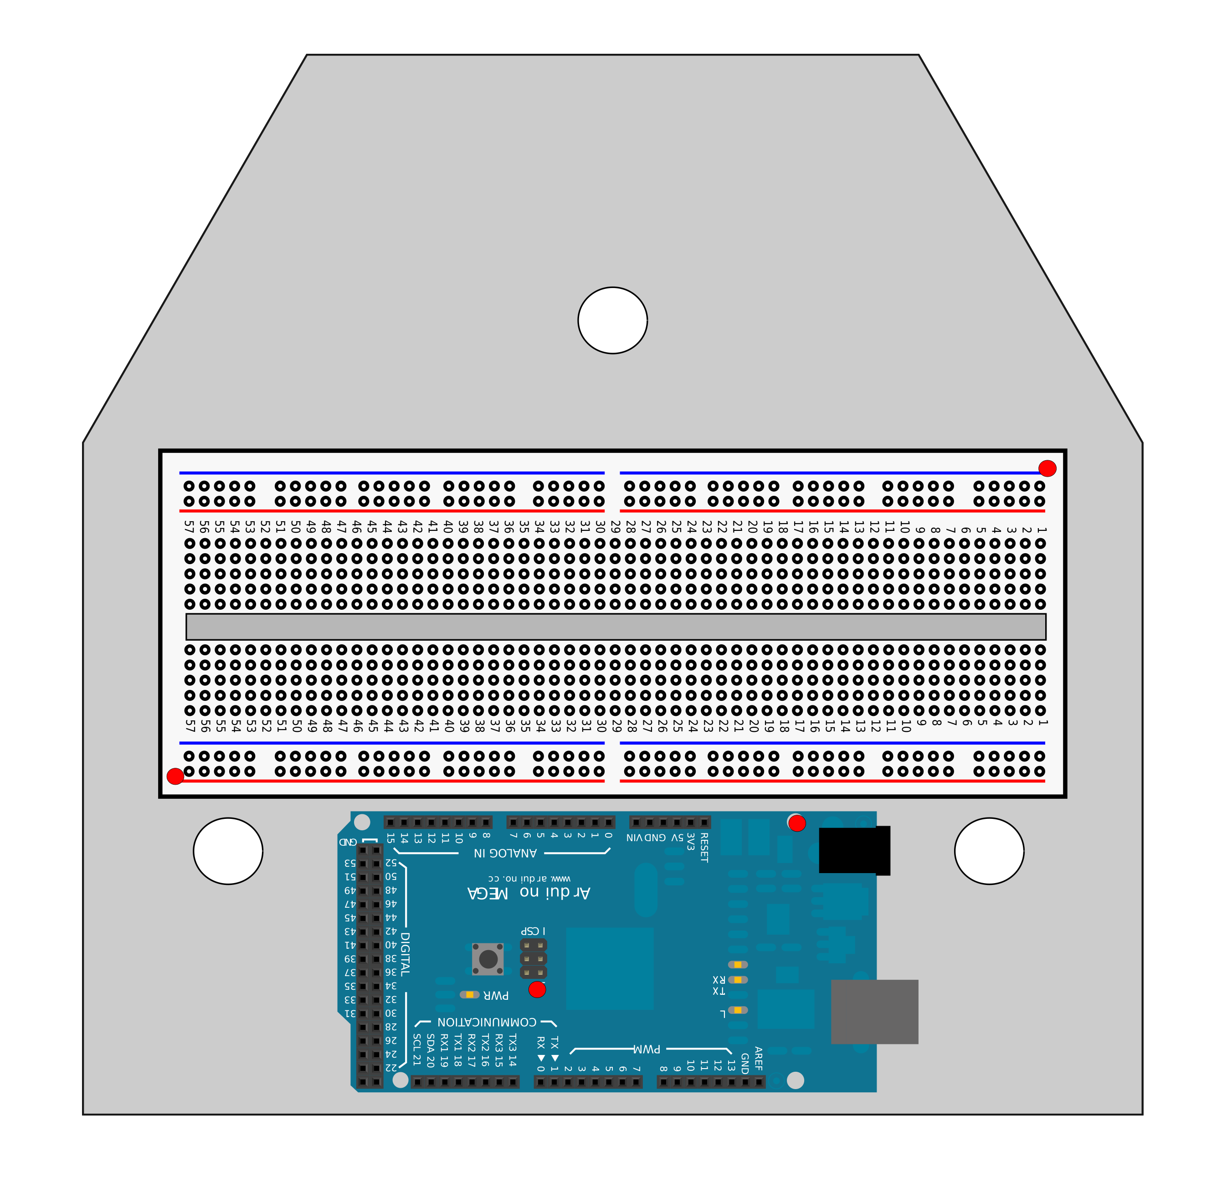
2019GSTWk3/B3_Documentation/B3_Chassis_Layout_Top.png
