OldFORTRANdog/GST_Arduino_Robotics/Documentation/2021/B3_BlinkBumpLightIR2021_bb.png

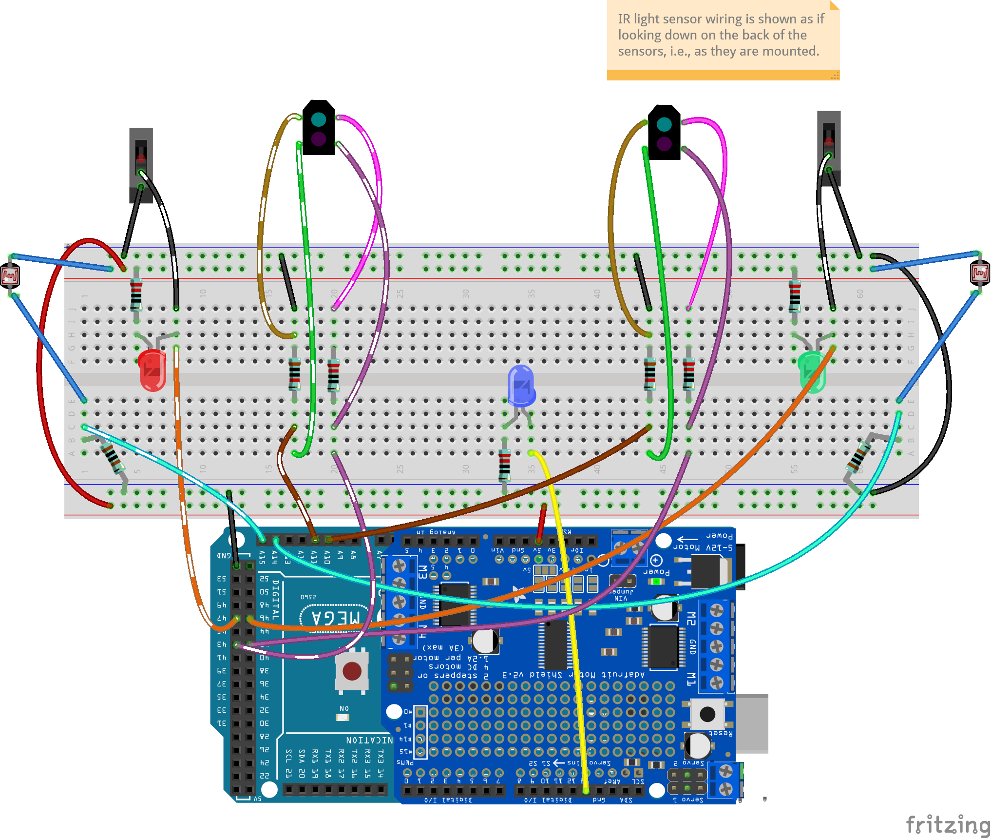
Documentation/2021/B3_BlinkBumpLightIR2021_bb.png
