OldFORTRANdog/GST_Arduino_Robotics/Documentation/2023/B3_Chassis_Top_Motor_wires.png

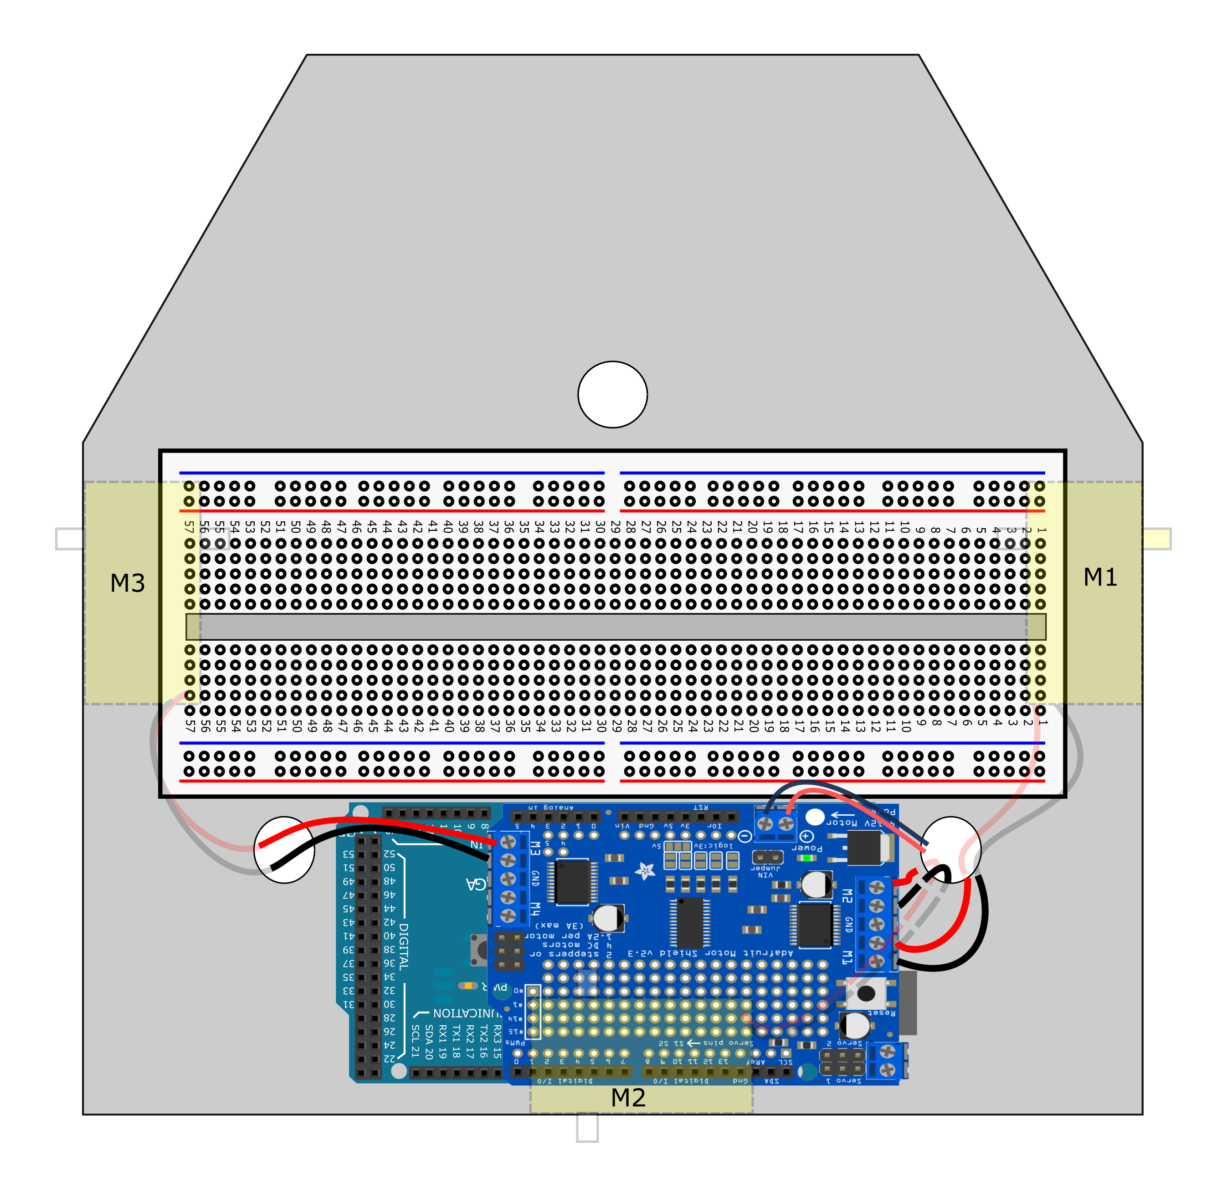
Documentation/2023/B3_Chassis_Top_Motor_wires.png
