OldFORTRANdog/GST_Arduino_Robotics/Documentation/2024/B3_BlinkBumpLightIR_2024.png

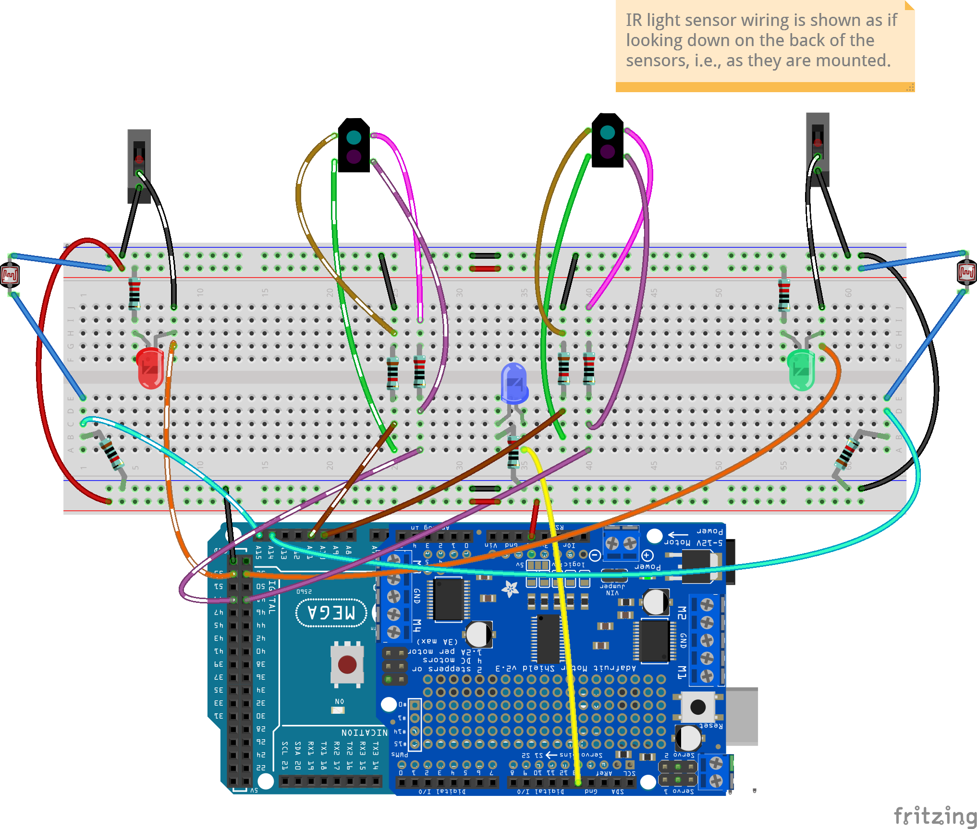
Documentation/2024/B3_BlinkBumpLightIR_2024.png
