OldFORTRANdog/GST_Arduino_Robotics/Documentation/2024/B3_BlinkBumpLightIRSonicServos_2024.png

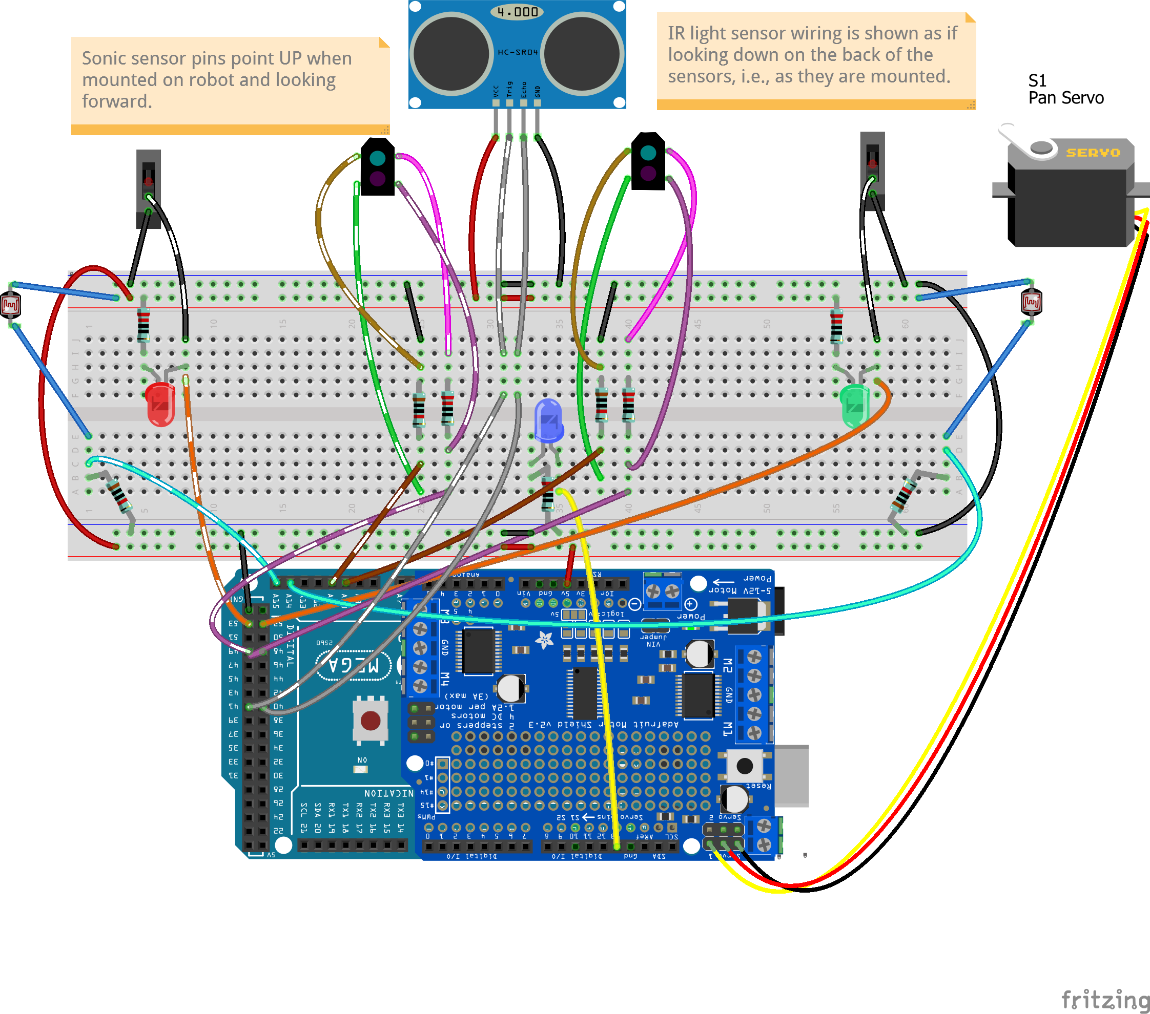
Documentation/2024/B3_BlinkBumpLightIRSonicServos_2024.png
