OldFORTRANdog/GST_Arduino_Robotics/Documentation/2024/B3_motor_wires_2024.png

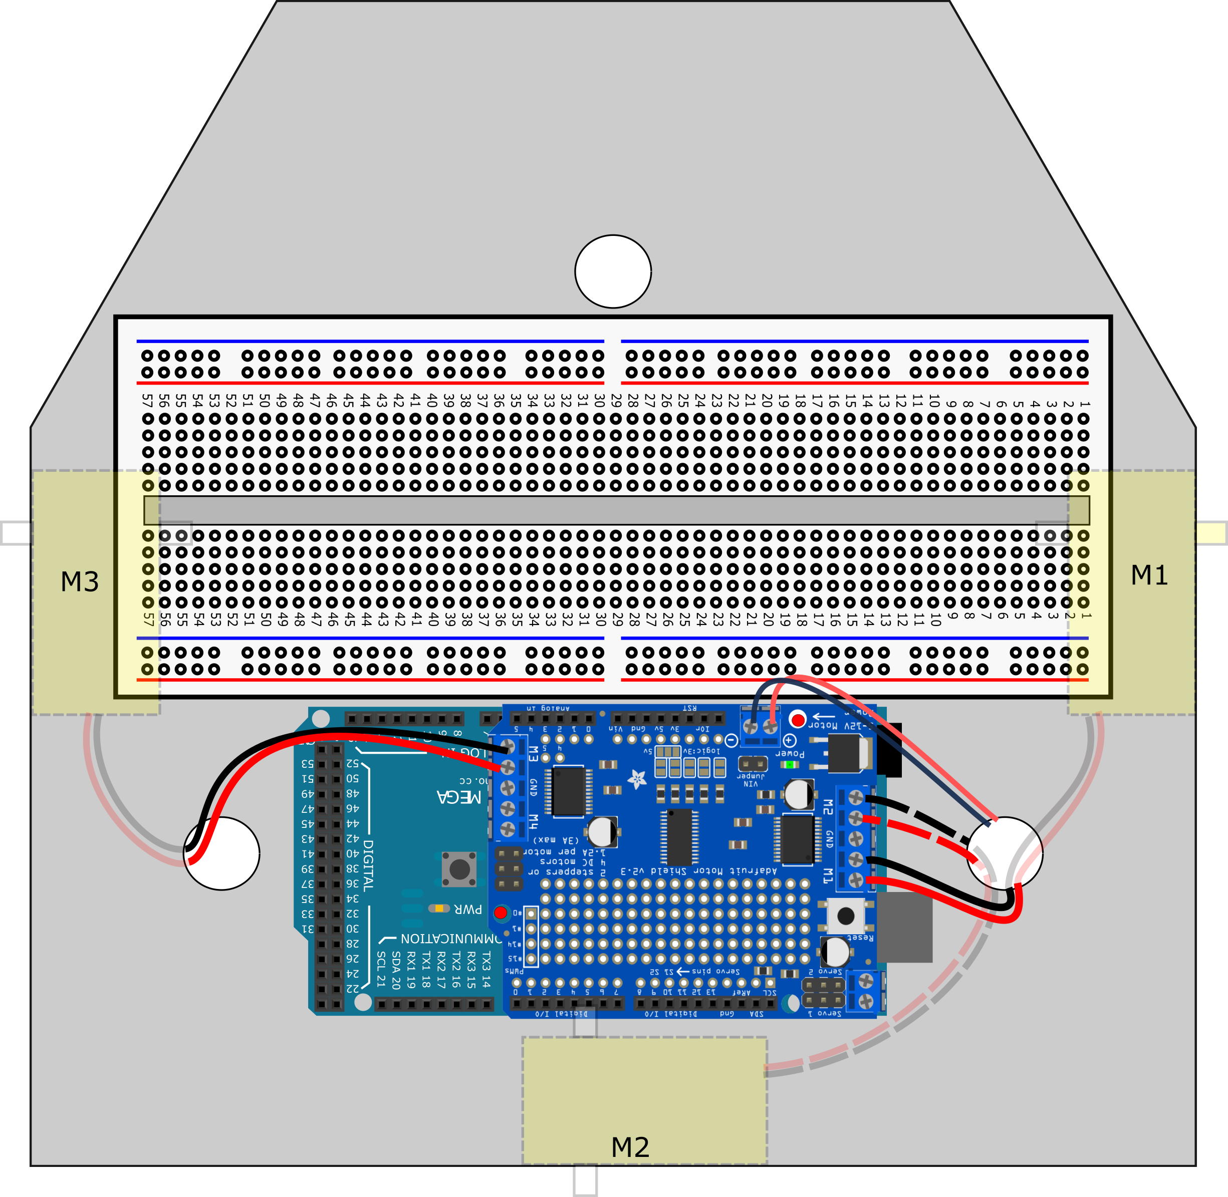
Documentation/2024/B3_motor_wires_2024.png
