OldFORTRANdog/GST_Arduino_Robotics/Documentation/Adafruit_Motor_Shield_bb.png

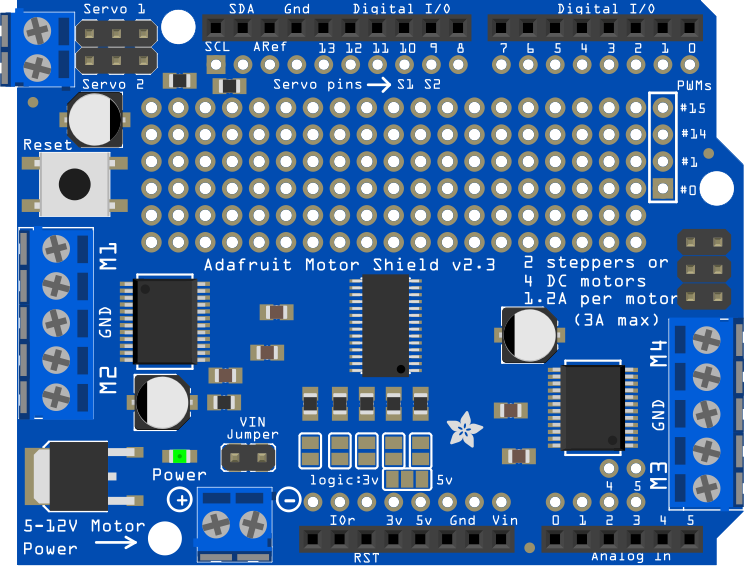
Documentation/Adafruit_Motor_Shield_bb.png
