OldFORTRANdog/GST_Arduino_Robotics/Documentation/B3_Bottom_holes_omni.png

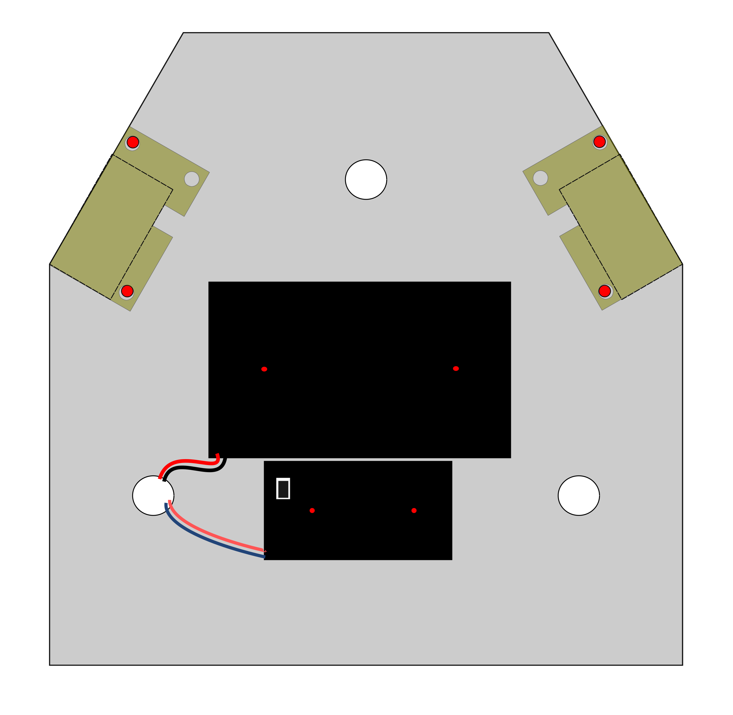
Documentation/B3_Bottom_holes_omni.png
