OldFORTRANdog/GST_Arduino_Robotics/Documentation/B3_Bottom_holes_straight.png

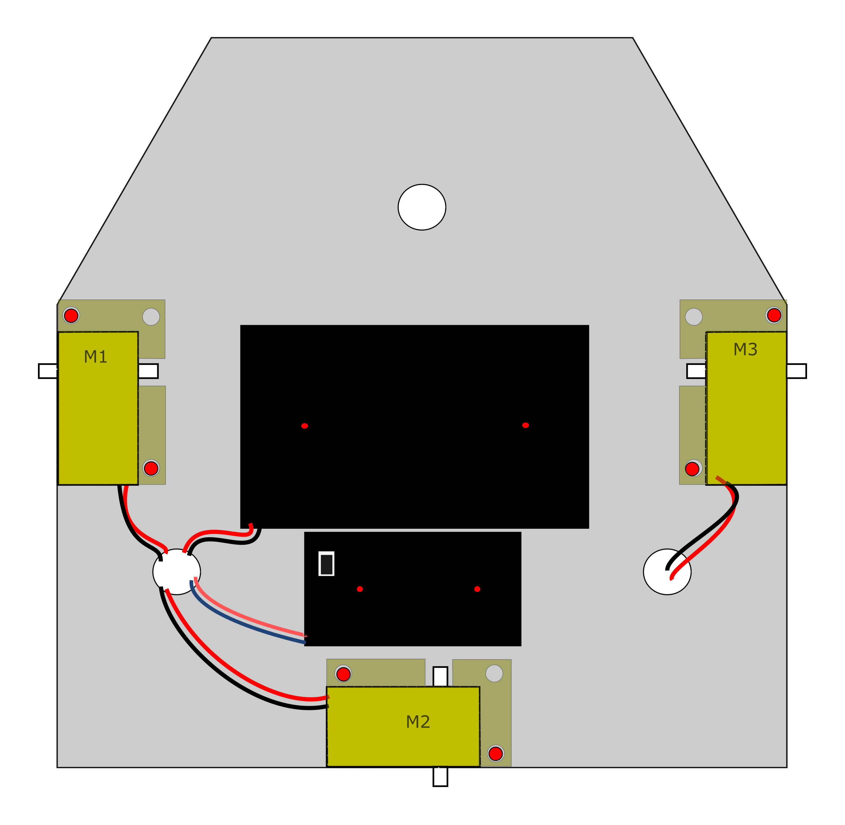
Documentation/B3_Bottom_holes_straight.png
