OldFORTRANdog/GST_Arduino_Robotics/Documentation/B3_Motor_wires.png

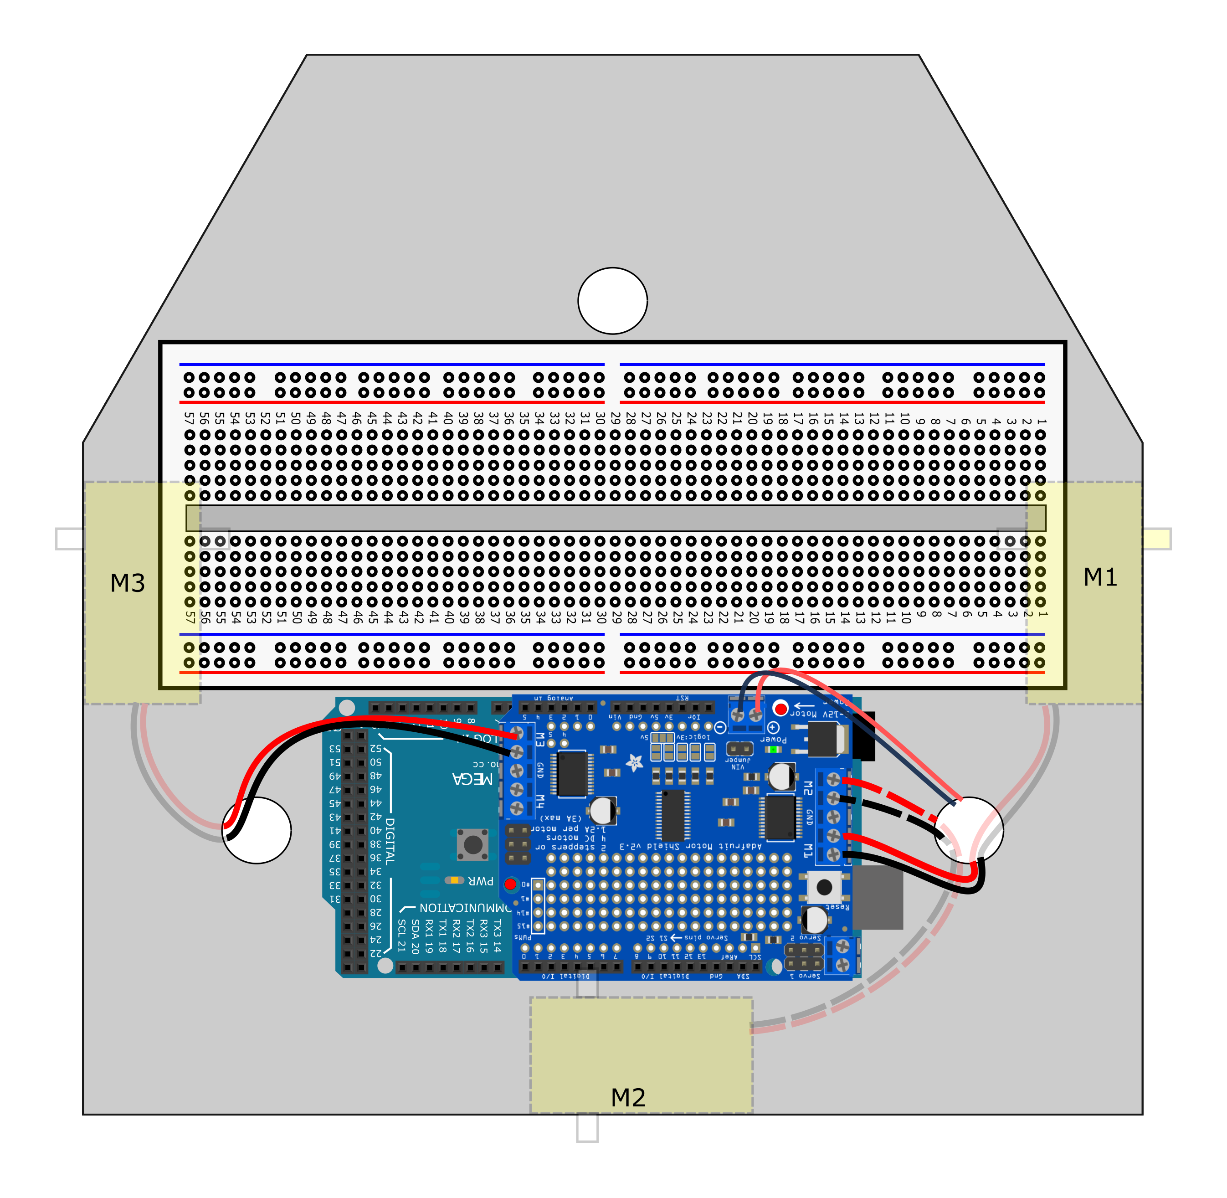
Documentation/B3_Motor_wires.png
