OldFORTRANdog/GST_Arduino_Robotics/Documentation/B3_Top_layout_holes.png

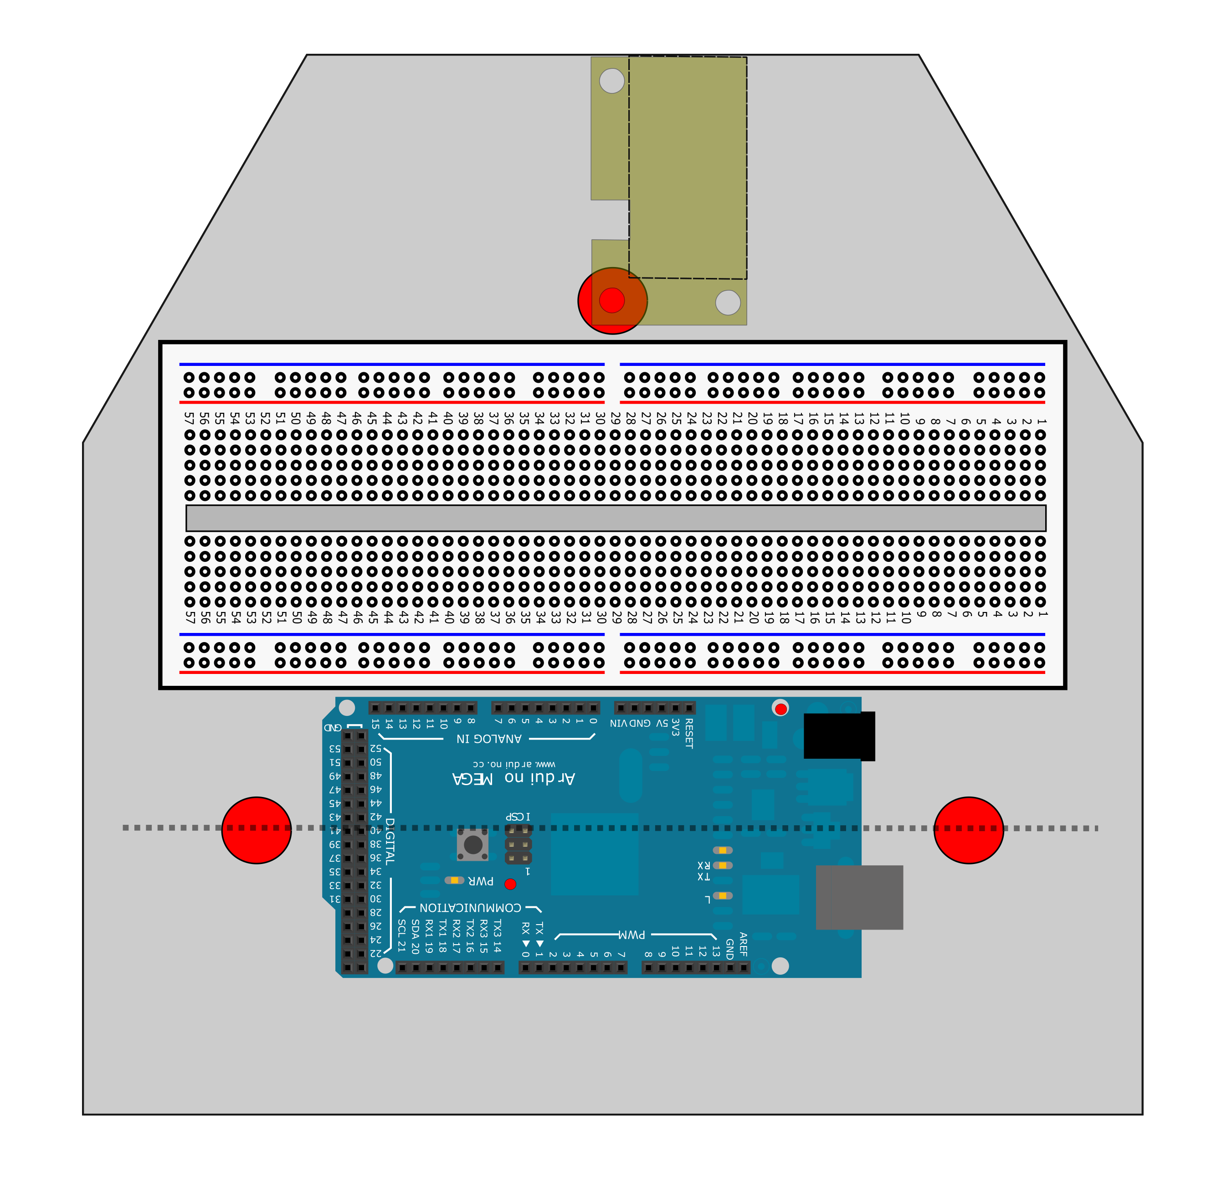
Documentation/B3_Top_layout_holes.png
