OldFORTRANdog/GST_Arduino_Robotics/Documentation/LectureNotes/g1364.png

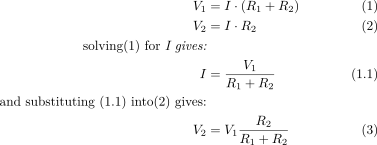
Documentation/LectureNotes/g1364.png
