OldFORTRANdog/GST_Arduino_Robotics/Documentation/LectureNotes/Voltage_divider.png

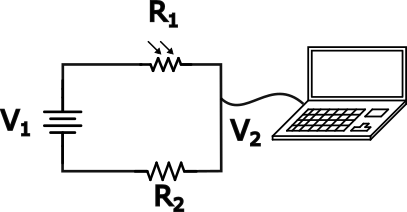
Documentation/LectureNotes/Voltage_divider.png
