OldFORTRANdog/GST_Arduino_Robotics/2019GSTWk3/B3_Documentation/B3_Wiring_Blue_Breadboard.pdf

Blink

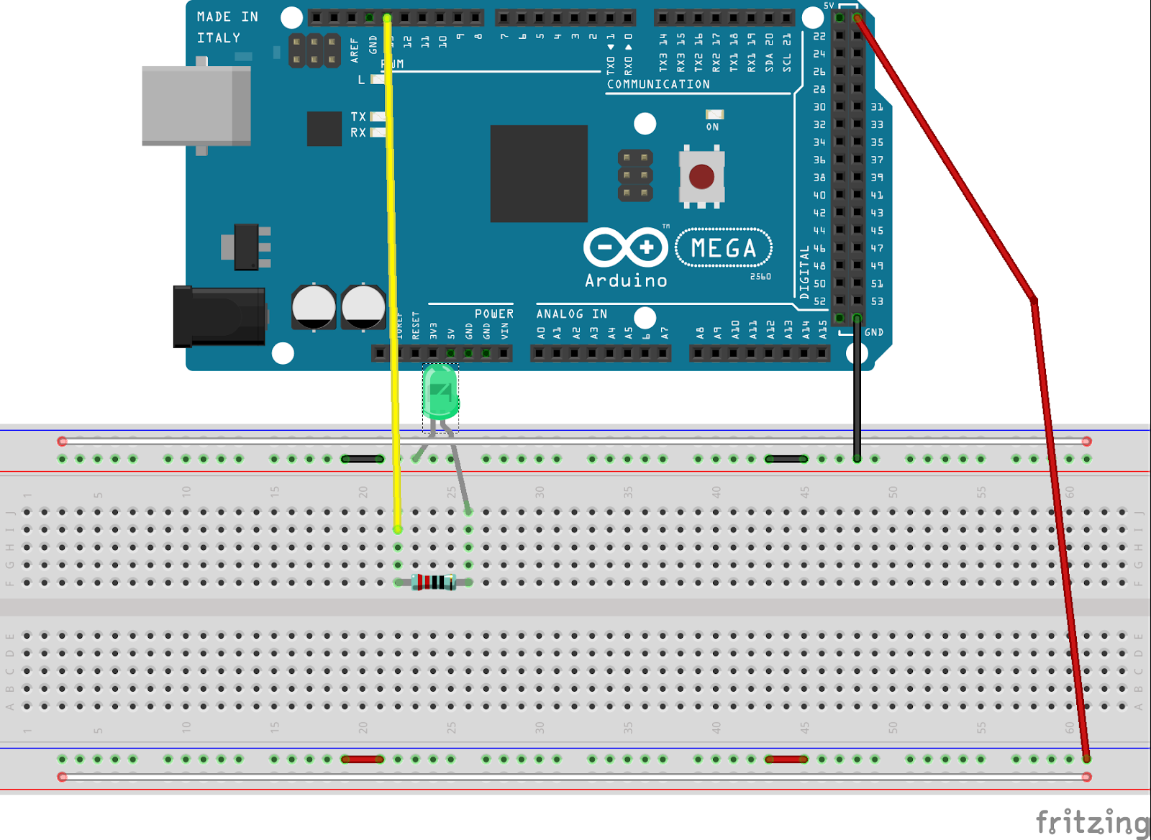
[picture p60: figure]

Blink and Bump Sensors

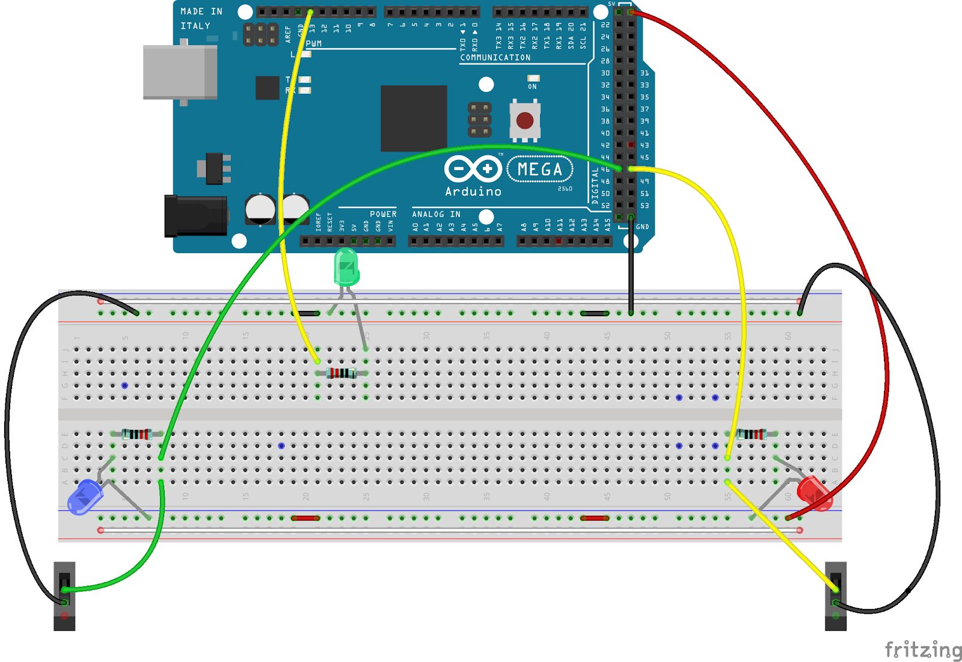
[picture p61: figure]

Blink, Bump and Light

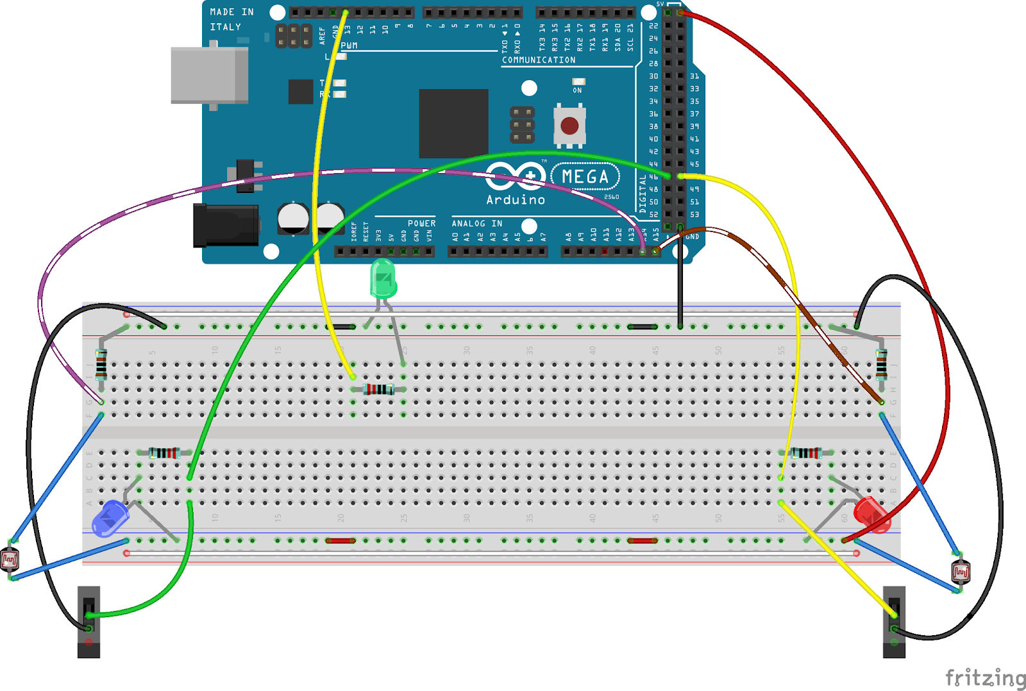
[picture p62: figure]

Blink, Bump, Light and Line Sensor

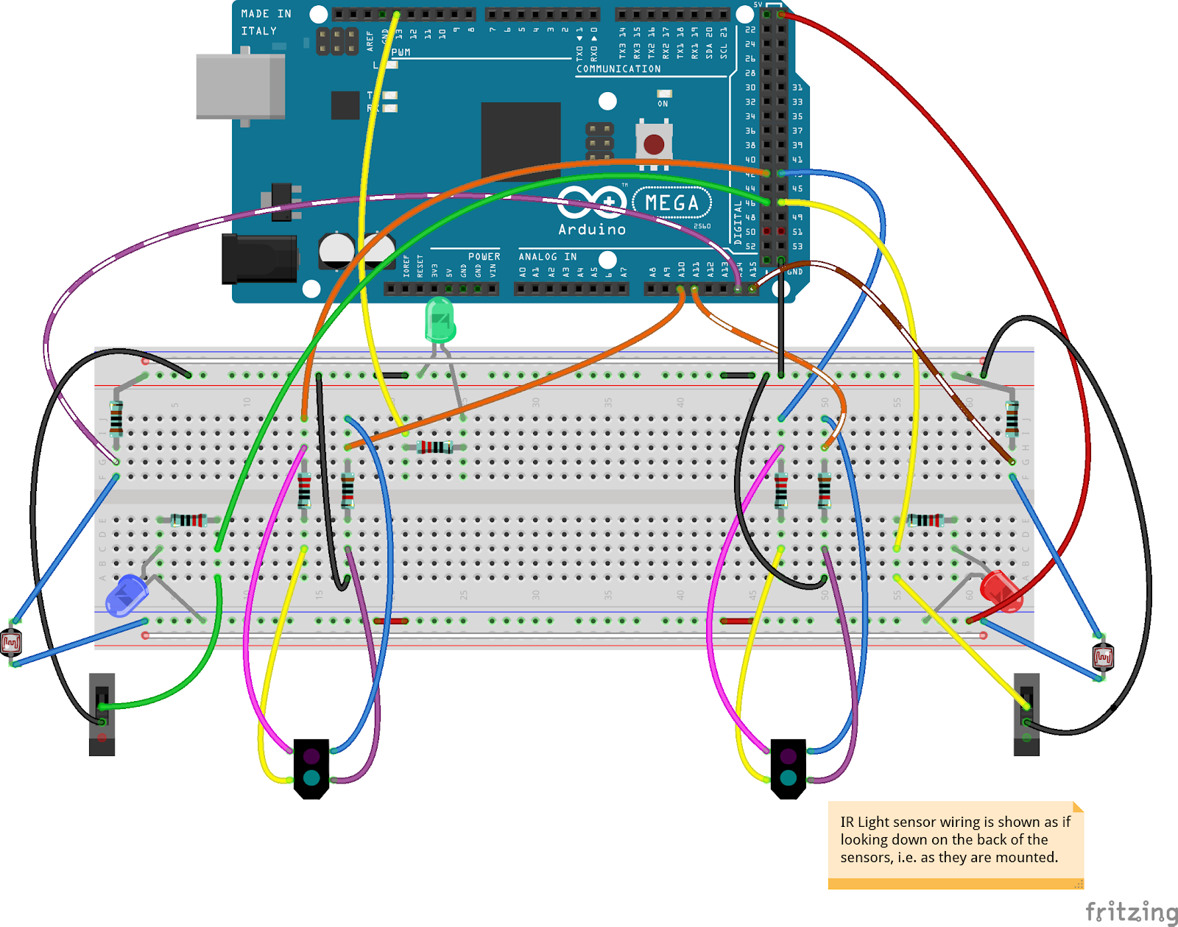
[picture p63: figure]

Blin

k, B

u

m

p, Lig

h

t, Lin

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
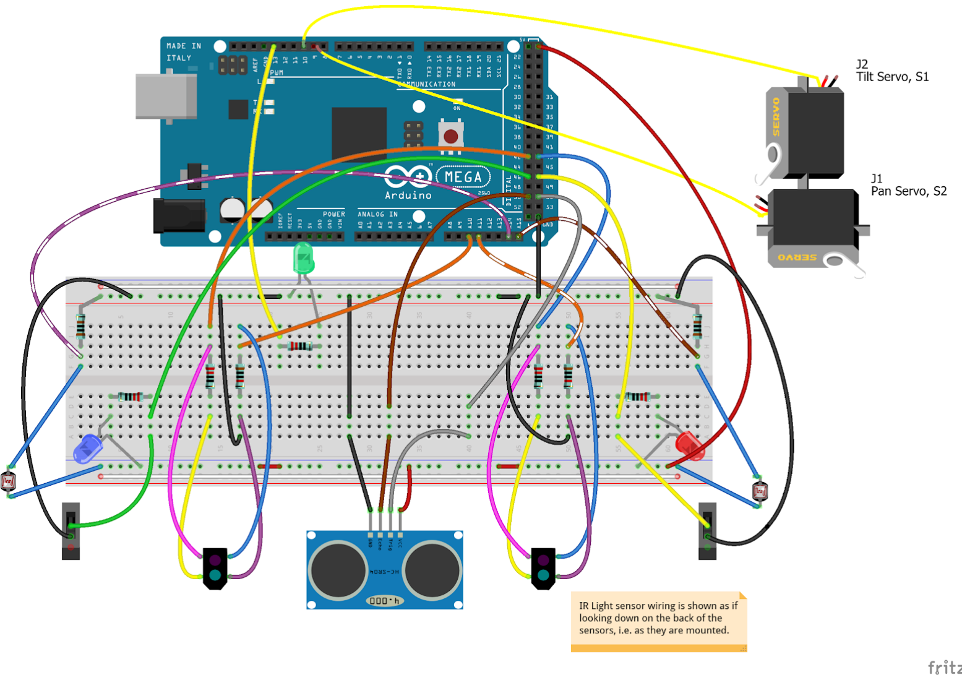
[picture p64: figure]
