OldFORTRANdog/GST_Arduino_Robotics/Documentation/LectureNotes/Equation_test.pptx

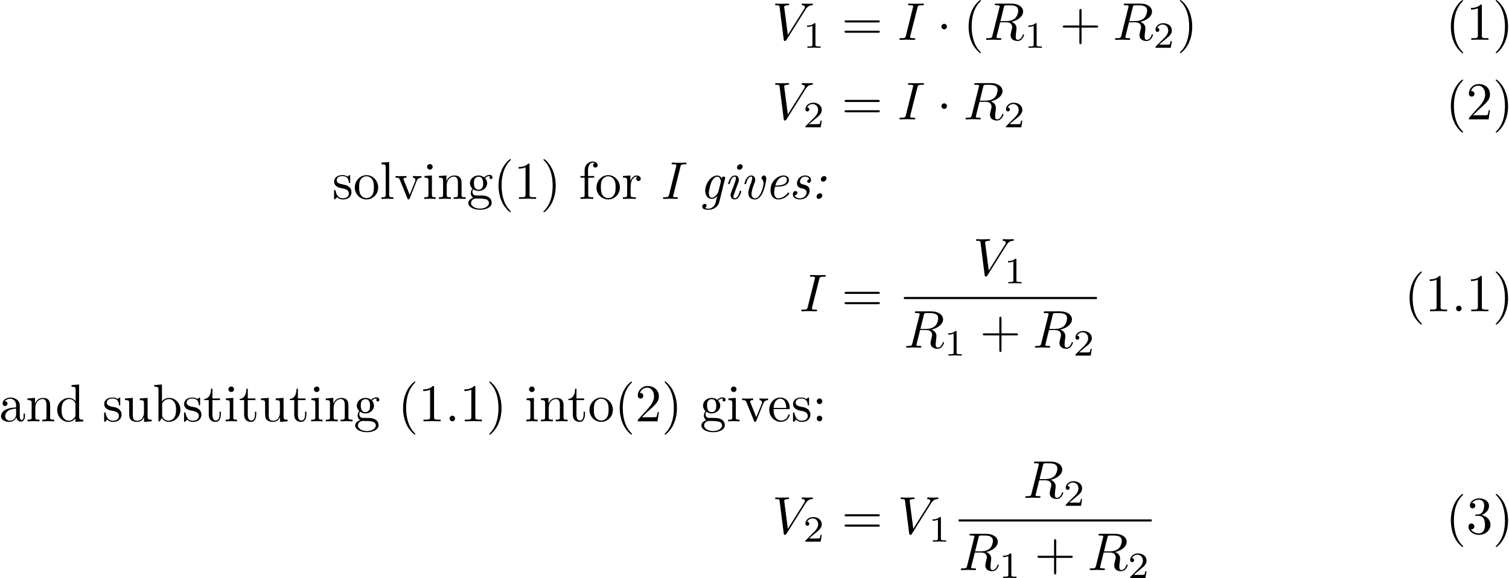
[picture p65: figure]

## Slide 2

V_1 =I×(R_1 +R_2 )
V_2 = I×R_2
Rewriting the first equation gives:
I=(V_1)/(R_1 +R_2)
