OldFORTRANdog/GST_Arduino_Robotics/(list of files, drawings)

Other design files:
Documentation/2021/B3_BlinkBumpLightIRSonicServos2021.fzz
Documentation/2024/B3_BlinkBumpLightIRSonicServos2024.fzz
