OldFORTRANdog/GST_Arduino_Robotics/to_distribute/sketchbook/B3_09B_Servo_Sonic/B3_09B_Servo_Sonic.ino

/* B3_09_Servo_Sonic.ino

   Drive the TWO-WHEELED Bread Board Bot (BBbot, B^3)
   forward.   When within TARGET_DISTANCE_INCHES inches of something,
   turn servos to find clearest path and then go that way.
   When a whisker bump sensor on either side hits something,
   back up and turn slightly away from that direction and resume
   forward path.

   Stop at a specified distance from an object directly ahead.

   N.B.: When the pan servo is mounted with the control wire coming
   out toward the back of the robot, then 180 in servo coordinates is
   all the way LEFT and 0 is all the way RIGHT.  The B^3 coordinates
   are from -90 all the way left to 90, all the way right.  We need to
   use a map() function to correct for this.

   Arduino: Arduino Mega 256 v3 Clone
   Motor Shield: Adafruit assembled Motor Shield for Arduino v2
   ---->  http://www.adafruit.com/products/1438

   Programmer: Dave Eslinger (DLE); June 13, 2015
   Revisions:
	  June 23, 2016:	Added sonic sensors on servos. DLE
    June 21, 2018:	Fixed coordinate issues with map() and
		       added sonic.ping_median calls. DLE
    June 19, 2022: Commented out Tilt Servo entries.  New build only uses Pan servo.
    June 24, 2023: Added logic to SOnic testing to account for NewPing library 
            returning a value of 0 when maximum distance is exceeded, i.e., no return. 
            Program can now use the default, unmodified NewPing library.
      TO TEST: Should not need to use sonic.ping_median, which was used to drop the "random"
            zeros that were previously being returned. DLE 
      TESTED 7/7/2023, still needed, otherwise get a lot of spurious 0's.
    July 7, 2023: Changed bump pin assignments, added precompiler option, changed number
            of calls in used ping_medium. DLE

*/
#include <Adafruit_MotorShield.h>
#include <BreadBoardBot.h>
#include <Servo.h>
#include <NewPing.h>  // Another new library, this one to use the sonic sensor

// Option to change sonar behavior
// #define NO_ECHO 500   // Changes value used in NewPing library when there is no sonar return.


// Create the motor shield object with the default I2C address
Adafruit_MotorShield AFMS = Adafruit_MotorShield();

// Define Servos
Servo panServo;
//Servo tiltServo;

/* Define Constants */

// IO Pins used
const byte LEFT_BUMP_PIN = 53;   // Define DIGITAL Pins for left
const byte RIGHT_BUMP_PIN = 52;  // and right bump sensors
const byte SONIC_TRIGGER_PIN = 41;
const byte SONIC_ECHO_PIN = 40;

// Parameters controlling program behavior
// Bump behavior
const byte FORWARD_SPEED = 100;   // Define normal speeds
const byte BACKWARD_SPEED = 100;  // and backup/turn speed
const int TURN_DURATION = 600;    // Turn length in milliseconds

// Sonic sensor
const float TARGET_DISTANCE_INCHES = 7;
const int MAX_SONIC_DISTANCE = 100;  // cm, optional, 500 cm is default

// Define 'ports' for motors.
const byte LEFT_MOTOR_PORT = 3;
const byte RIGHT_MOTOR_PORT = 1;
// Create pointers to motor control objects
Adafruit_DCMotor *motorLeft = AFMS.getMotor(LEFT_MOTOR_PORT);
Adafruit_DCMotor *motorRight = AFMS.getMotor(RIGHT_MOTOR_PORT);

/* Define new untrasonic sensor with trigger & echo pins and
   the maximum distance to be sensed. */
NewPing sonic(SONIC_TRIGGER_PIN, SONIC_ECHO_PIN, MAX_SONIC_DISTANCE);

/* Define servo pins */
const byte PANSERVOPIN = 10;  // Arduino pint 10 is used for Servo 1 on AdaFruit Motor Shield
//const byte TILTSERVOPIN = 9; // Arduino pint 9 is used for Servo 2

float pingDist;  // define variable to use for distance measurements


void setup(void) {
  AFMS.begin();  // create with the default frequency 1.6KHz
  // Turn off all motors to start, just a good habit
  motorLeft->run(RELEASE);
  motorRight->run(RELEASE);

  panServo.attach(PANSERVOPIN);
  //  tiltServo.attach(TILTSERVOPIN);
  panServo.write(90);
  //  tiltServo.write(90);

  Serial.begin(9600);  //Begin serial communcation

  /*Set up Bump Pins with Arduino internal pullup resistors
    This will make them always high unless a bump switch is hit,
    which will make a connection to ground and they will read low. */
  pinMode(LEFT_BUMP_PIN, INPUT_PULLUP);
  pinMode(RIGHT_BUMP_PIN, INPUT_PULLUP);

  pinMode(SONIC_TRIGGER_PIN, OUTPUT);
  pinMode(SONIC_ECHO_PIN, INPUT);

  // Now wait for the RIGHT bumpsensor to be pressed
  while (digitalRead(RIGHT_BUMP_PIN)) {};
  while (!digitalRead(RIGHT_BUMP_PIN)) {};
  delay(600);  // Bump pin triggered and released, just give 0.6 seconds to get hands out of the way.
}

void loop() {

  // Test some of the sonic library functions:
  Serial.print(sonic.ping_in());
  Serial.print(" inches, cm = ");
  Serial.print(sonic.ping_cm());
  Serial.print(", ping time (ms) = ");
  // int ping_milli = sonic.ping_median(5);
  int ping_milli = sonic.ping_median(5);
  Serial.print(ping_milli);
  Serial.print(", real inches = ");
  Serial.print(Distance_inches(ping_milli));
  Serial.print(", real cm = ");
  Serial.print(Distance_cm(ping_milli));
  Serial.print(", med ping = ");
  Serial.println(sonic.ping_median(5));
  Serial.print("NO_ECHO = ");
  Serial.println(NO_ECHO);

  //   Assuming no switches closed initially.  Drive forward:
  motorLeft->setSpeed(FORWARD_SPEED);
  motorRight->setSpeed(FORWARD_SPEED);
  pingDist = Distance_inches(sonic.ping_median(5));
  Serial.println("First straight distance = " + String(pingDist));
  while (digitalRead(LEFT_BUMP_PIN) && digitalRead(RIGHT_BUMP_PIN)
         && (pingDist > TARGET_DISTANCE_INCHES
             || pingDist <= 1.0)) {
    motorLeft->run(FORWARD);
    motorRight->run(FORWARD);
    pingDist = Distance_inches(sonic.ping_median(5));
    Serial.println("Straight distance = " + String(pingDist));
  }

  // If you got here, one of the bump switches was closed or B3 is too
  // close to something straight ahead

  // First check the LEFT sensor:
  if (!digitalRead(LEFT_BUMP_PIN)) {          // the LEFT side switch was bumped
    motorLeft->setSpeed(BACKWARD_SPEED / 3);  // Slowly back up and turn to right
    motorRight->setSpeed(BACKWARD_SPEED);
    motorLeft->run(BACKWARD);
    motorRight->run(BACKWARD);
    delay(TURN_DURATION);      // for specified duration
    motorLeft->run(RELEASE);   // Then stop power to the motors
    motorRight->run(RELEASE);  // and move to next section of code
  }
  // Then check the right sensor:
  else if (!digitalRead(RIGHT_BUMP_PIN)) {  // the RIGHT side switch was bumped
    motorLeft->setSpeed(BACKWARD_SPEED);    // Slowly back up and turn to left
    motorRight->setSpeed(BACKWARD_SPEED / 3);
    motorLeft->run(BACKWARD);
    motorRight->run(BACKWARD);
    delay(TURN_DURATION);      // for specified duration
    motorLeft->run(RELEASE);   // Then stop power to the motors
    motorRight->run(RELEASE);  // and move to next section of code
  }
  // It must have been the sonar sensor
  else {
    motorLeft->run(RELEASE);    // So stop power to the motors
    motorRight->run(RELEASE);   // and move to next section of code
    motorLeft->run(BACKWARD);   // So REVERSE power to the motors
    motorRight->run(BACKWARD);  // to BRIEFLY APPLY a brake
    delay(50);
    motorLeft->run(RELEASE);   // Then stop power to the motors
    motorRight->run(RELEASE);  // and move to next section of code
    float maxDist = -999.;
    int newDirection = 0;

    for (int i = 5; i <= 175; i += 5) {
      panServo.write(i);
      pingDist = Distance_inches(sonic.ping_median());
      if (pingDist > maxDist) {
        //newDirection = i - 90;
        newDirection = map(i, 180, 0, -90, 90);
        maxDist = pingDist;
        String outMsg = String("New maximum distance is " + String(pingDist) + " at angle " + String(newDirection));
        Serial.println(outMsg);
      }
    }

    //	Now turn to the new maximumum direction!
    panServo.write(90);
    spin(newDirection, 75, motorLeft, motorRight);
    spinStop(newDirection, motorLeft, motorRight);  //Stops the spin
    delay(50);
  }

  /*That is all!  Now go back to the beginning of the loop and
     drive straight ahead until somehting is bumped. */
}

float Distance_inches(int ping) {
  float inches_per_sec = 13582.67;  // Equivilent to 345 m/s
  return ping * inches_per_sec * 1e-6 * 0.5;
}

float Distance_cm(int ping) {
  float cm_per_sec = 34500.;  // Equivilent to 345 m/s
  return ping * cm_per_sec * 1e-6 * 0.5;
}
