OldFORTRANdog/GST_Arduino_Robotics/to_distribute/sketchbook/B3_08_LineFollow/B3_08_LineFollow.ino

/* B3_LineFollow.ino
   Drive the TWO-WHEELED Bread Board Bot (BBbot, B^3)
   forward, following a black line, but pretty inefficiently.
   When a whisker bump sensor on either side hits something,
   back up and turn slightly away from that direction and resume
   forward path.
   Stop at a specified distance from an object directly ahead.
   Arduino: Arduino Mega 256 v3 Clone
   Motor Shield: Adafruit assembled Motor Shield for Arduino v2
   ---->  http://www.adafruit.com/products/1438
   Programmer: Dave Eslinger; June 13, 2015
   Revisions: June 26, 2022 SLOW_FACTOR added, DLE
              June 24, 2023, SLOW_FACTOR as float and clarify comments
              2023, July 7: Changed bump pin assignments. DLE
*/
#include <Adafruit_MotorShield.h>
#include <BreadBoardBot.h>

// Create the motor shield object with the default I2C address
Adafruit_MotorShield AFMS = Adafruit_MotorShield();

/* Define Constants */

// IO Pins used
const byte LEFT_BUMP_PIN = 53;    // Define DIGITAL Pins for left
const byte RIGHT_BUMP_PIN = 52;   // and right bump sensors
const byte LEFT_IR_LED_PIN = 49;
const byte LEFT_IR_PIN = A11;
const byte RIGHT_IR_LED_PIN = 48;
const byte RIGHT_IR_PIN = A10;

// Parameters controlling program behavior
// Bump behavior
const byte FORWARD_SPEED = 120;   // Define normal speeds
const float  SLOW_FACTOR = 0.3;     // Amount to slow wheel for turning

// Line Following
const byte FOLLOW_LEFT_SIDE = 1;
const float HI_LIGHT = 0.80;     // Keep the BRIGHT side of the line ABOVE this
// fraction of the light range read by that sensor
const float LO_LIGHT = 0.20;     // Keep the DARK side of the line BELOW this
// fraction of the light range read by that sensor

// Define 'ports' for motors.
const byte LEFT_MOTOR_PORT = 3;
const byte RIGHT_MOTOR_PORT = 1;
// Create pointers to motor control objects
Adafruit_DCMotor *motorLeft = AFMS.getMotor(LEFT_MOTOR_PORT);
Adafruit_DCMotor *motorRight = AFMS.getMotor(RIGHT_MOTOR_PORT);

/* Global Variables */
int leftIR;
int minLeftIR = 1026;
int maxLeftIR = -1024;
int rightIR;
int minRightIR = 1026;
int maxRightIR = -1024;
float brightLeft;
float darkRight;
float leftRange;
float rightRange;

void setup(void) {
  AFMS.begin();  // create with the default frequency 1.6KHz
  // Turn off all motors to start, just a good habit
  motorLeft->run(RELEASE);
  motorRight->run(RELEASE);
  Serial.begin(9600);  //Begin serial communcation

  /*Set up Bump Pins with Arduino internal pullup resistors
    This will make them always high unless a bump switch is hit,
    which will make a connection to ground and they will read low. */
  pinMode(LEFT_BUMP_PIN, INPUT_PULLUP);
  pinMode(RIGHT_BUMP_PIN, INPUT_PULLUP);

  /* Define IR LED source pins as OUTPUTs and turn on the IR LEDs */
  pinMode(LEFT_IR_LED_PIN, OUTPUT);
  pinMode(RIGHT_IR_LED_PIN, OUTPUT);
  digitalWrite(LEFT_IR_LED_PIN, HIGH);
  digitalWrite(RIGHT_IR_LED_PIN, HIGH);

  /* Calibrate the IR sensors
     1) Place over the brightest target and hold down right bumper switch.
     2) Place over the darkest target and hold down right bumper again.
     3) All done!  The program
        calculates the 80% and 20% (or as set by HI_LIGHT% and LO_LIGHT% values)
        target values to keep the sensors at.
  */
  int lightNum = 0;
  while (digitalRead(RIGHT_BUMP_PIN) == HIGH) {} // Pause until the pin is grounded (our switch)
  delay(100);
  while (digitalRead(RIGHT_BUMP_PIN) == LOW) { // Get high light values until the pin
    // is no longer grounded
    leftIR = analogRead(LEFT_IR_PIN);
    rightIR = analogRead(RIGHT_IR_PIN);
    Serial.print(leftIR);
    Serial.print("  = leftIR, Calibrate LIGHT & Dark rightIR = ");
    Serial.println(rightIR);
    if ( leftIR > maxLeftIR ) {
      maxLeftIR = leftIR;
    }
    if ( leftIR < minLeftIR ) {
      minLeftIR = leftIR;
    }
    if ( rightIR > maxRightIR ) {
      maxRightIR = rightIR;
    }
    if ( rightIR < minRightIR ) {
      minRightIR = rightIR;
    }
  }
  leftRange = maxLeftIR - minLeftIR;
  rightRange = maxRightIR - minRightIR;
  brightLeft = maxLeftIR - ((1.0 - HI_LIGHT) * leftRange);
  darkRight = minRightIR + (LO_LIGHT * rightRange);

  while ( digitalRead(LEFT_BUMP_PIN) == HIGH) {} // Pause until you trigger the left bump switch
  delay(1000);                      // Then wait 1 second and start line following.
}

void loop() {
  byte leftSpeed, rightSpeed;
  leftIR = analogRead(LEFT_IR_PIN);
  rightIR = analogRead(RIGHT_IR_PIN);
  Serial.print(leftIR);           // We can only write ONE thing
  Serial.print(" = left, right = "); // at a time, therefore it takes
  Serial.println(rightIR);        // three statemens to get our output.

  if (leftIR >= brightLeft && rightIR <= darkRight) {
    leftSpeed = FORWARD_SPEED;
    rightSpeed = FORWARD_SPEED;
  }
  else if (leftIR < brightLeft ) {
    leftSpeed = FORWARD_SPEED * SLOW_FACTOR;       // Too far left, slow LEFT motor
    rightSpeed = FORWARD_SPEED;
  }
  else if (rightIR > darkRight) {
    rightSpeed = FORWARD_SPEED * SLOW_FACTOR;
    leftSpeed = FORWARD_SPEED;

  }
  motorLeft -> setSpeed(leftSpeed);
  motorRight-> setSpeed(rightSpeed);
//  Serial.println(String("leftSpeed, rightSpeed = " + String(leftSpeed) + ", " + String(rightSpeed)));
  motorLeft->run(FORWARD);
  motorRight->run(FORWARD);
  delay(20);
}
