OldFORTRANdog/GST_Arduino_Robotics/to_distribute/sketchbook/B3_07_Light/B3_07_Light.ino

/* B3_07_Light.ino

   Drive the TWO-WHEELED Bread Board Bot (BBbot, B^3)
   either towards the light or away from the light, based on readings
   from two photresistors.  Each resistor is set up in a simple voltage
   divider circuit:
   ----------------------------------------------------

                       PhotoR   ~7.5-10K
               +5  o---/\/\/--.--/\/\/---o GND
                              |
       Sensor Pins o-----------

   ----------------------------------------------------
   Modified from: http://playground.arduino.cc/Learning/PhotoResistor

   Arduino: Arduino Mega 256 v3 Clone
   Motor Shield: Adafruit assembled Motor Shield for Arduino v2
   ---->  http://www.adafruit.com/products/1438

   Programmer: Dave Eslinger; June 7, 2015
   Revisions:
              2023, July 7: Changed bump pin assignments. DLE
*/
#include <Adafruit_MotorShield.h>
#include <BreadBoardBot.h>

// Create the motor shield object with the default I2C address
Adafruit_MotorShield AFMS = Adafruit_MotorShield();

// Define Constants

const byte LEFT_PR_PIN = A15; //A15   // Define light sensor pins for left
const byte RIGHT_PR_PIN = A14;//A14   // and right sides
const bool PHOTOTAXIS = true;    // Goes towards light (true) or away (false)
const byte BASESPEED = 75;       // Base speed.  Light values will reduce this to turn
const bool SIMPLE_LOGIC = false; // Use a simple or more complex approach
// Define Bump Pin Assignments: CHANGE AS NEEDED DEPENDING ON HOW YOUR BUMP FEELERS POINT!
const byte LEFT_BUMP_PIN = 53;    // Define DIGITAL Pins for left
const byte RIGHT_BUMP_PIN = 52;   // and right bump sensors

// Define 'ports' for motors.
const byte LEFT_MOTOR_PORT = 3;
const byte RIGHT_MOTOR_PORT = 1;
// Create pointers to motor control objects
Adafruit_DCMotor *motorLeft = AFMS.getMotor(LEFT_MOTOR_PORT);
Adafruit_DCMotor *motorRight = AFMS.getMotor(RIGHT_MOTOR_PORT);


void setup(void) {
  AFMS.begin();  // create with the default frequency 1.6KHz
  // Turn off all motors to start, just a good habit
  motorLeft->run(RELEASE);
  motorRight->run(RELEASE);
  Serial.begin(9600);  //Begin serial communcation

  // Now wait for the RIGHT bumpsensor to be pressed
  while (digitalRead(RIGHT_BUMP_PIN)) {};
  while (!digitalRead(RIGHT_BUMP_PIN)) {};
  delay(600); // Bump pin triggered and released, just give 0.6 seconds to get hands out of the way.
}

void loop() {
  /*  First determine the relative light levels and print the
      results out to the serial monitor */
  int leftLight = analogRead(LEFT_PR_PIN);
  int rightLight = analogRead(RIGHT_PR_PIN);
  Serial.print(leftLight);           // We can only write ONE thing
  Serial.print(" = left, right = "); // at a time, therefore it takes
  Serial.println(rightLight);        // three statemens to get our output.

  /* Now that we have some light levels, make each motor's speed
     a function of light level and drive either towards or
     away from the light depending on the value of PHOTOAXIS  */
  if (SIMPLE_LOGIC) {
    motorLeft->setSpeed(map(rightLight, 0, 500, 50, 255));
    motorRight->setSpeed(map(leftLight, 0, 500, 50, 255));
    byte direction;
    if (PHOTOTAXIS) {
      direction = FORWARD;
    }
    else {
      direction = BACKWARD;
    }
    motorLeft->run(direction);
    motorRight->run(direction);
  }
  else {
    /* Find the direction of the strongest light by taking the difference
        between the readings */
    int deltaLight = abs(leftLight - rightLight);
    deltaLight = constrain(deltaLight, 0, BASESPEED);  // Keep that limit between 0 and max speed

    byte leftSpeed = BASESPEED;
    byte rightSpeed = BASESPEED;

    if (PHOTOTAXIS) {
      if (leftLight - rightLight > 0) {       // The LEFT side is the brightest,
        leftSpeed = leftSpeed - deltaLight;   // slow down the LEFT side to turn towards it
      }
      else if (leftLight - rightLight < 0 ) { // The RIGHT side is the brightest,
        rightSpeed = rightSpeed - deltaLight; // slow down the RIGHT side to turn towards it
      }
    }
    else {
      if (leftLight - rightLight > 0) {       // The LEFT side is the brightest,
        rightSpeed = rightSpeed - deltaLight; // slow down the RIGHT side to turn away
      }
      else if (leftLight - rightLight < 0 ) { // The Right side is the brightest,
        leftSpeed = leftSpeed - deltaLight;   // slow down the LEFT side to turn away
      }
    }
    motorLeft->setSpeed(leftSpeed);
    motorRight->setSpeed(rightSpeed);
    motorLeft->run(FORWARD);
    motorRight->run(FORWARD);
  }
  delay(10); //Use a short delay.
}
