OldFORTRANdog/GST_Arduino_Robotics/to_distribute/sketchbook/Extras/ImperialMarch/ImperialMarch.ino

/* Imperial March from Instructables:
    https://www.instructables.com/id/How-to-easily-play-music-with-buzzer-on-arduino-Th/

Copied for GoSciTech Arduino Robotics, July 9, 2019 by Dave Eslinger.
  Modified to used TONE_PIN instead of hard-coded pin 8, and

*/

// NB: ALL NOTES DEFINED WITH STANDARD ENGLISH NAMES, EXCEPT FROM "A"
//THAT IS CALLED WITH THE ITALIAN NAME "LA" BECAUSE A0,A1...ARE THE ANALOG PINS ON ARDUINO.
// (Ab IS CALLED Ab AND NOT LAb)
#define	C0 16.35
#define	Db0	17.32
#define	D0	18.35
#define	Eb0	19.45
#define	E0	20.60
#define	F0	21.83
#define	Gb0	23.12
#define	G0	24.50
#define	Ab0	25.96
#define	LA0	27.50
#define	Bb0	29.14
#define	B0	30.87
#define	C1	32.70
#define	Db1	34.65
#define	D1	36.71
#define	Eb1	38.89
#define	E1	41.20
#define	F1	43.65
#define	Gb1	46.25
#define	G1	49.00
#define	Ab1	51.91
#define	LA1	55.00
#define	Bb1	58.27
#define	B1	61.74
#define	C2	65.41
#define	Db2	69.30
#define	D2	73.42
#define	Eb2	77.78
#define	E2	82.41
#define	F2	87.31
#define	Gb2	92.50
#define	G2	98.00
#define	Ab2	103.83
#define	LA2	110.00
#define	Bb2	116.54
#define	B2	123.47
#define	C3	130.81
#define	Db3	138.59
#define	D3	146.83
#define	Eb3	155.56
#define	E3	164.81
#define	F3	174.61
#define	Gb3	185.00
#define	G3	196.00
#define	Ab3	207.65
#define	LA3	220.00
#define	Bb3	233.08
#define	B3	246.94
#define	C4	261.63
#define	Db4	277.18
#define	D4	293.66
#define	Eb4	311.13
#define	E4	329.63
#define	F4	349.23
#define	Gb4	369.99
#define	G4	392.00
#define	Ab4	415.30
#define	LA4	440.00
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
    tone(TONE_PIN,B3,S);
    delay(1+S);
    tone(TONE_PIN,C4,E);
    delay(1+E);
    delay(1+E);//PAUSE QUASI FINE RIGA
    tone(TONE_PIN,F3,E);
    delay(1+E);
    tone(TONE_PIN,Ab3,Q);
    delay(1+Q);
    tone(TONE_PIN,F3,E+S);
    delay(1+E+S);
    tone(TONE_PIN,C4,S);
    delay(1+S);

    tone(TONE_PIN,LA3,Q);
    delay(1+Q);
     tone(TONE_PIN,F3,E+S);
    delay(1+E+S);
    tone(TONE_PIN,C4,S);
    delay(1+S);
    tone(TONE_PIN,LA3,H);
    delay(1+H);

    delay(2*H);

}
