OldFORTRANdog/GST_Arduino_Robotics/to_distribute/sketchbook/B3_00_Blink/B3_00_Blink.ino

/*
  Blink
  Turns on an LED on for one second, then off for one second, repeatedly.

  Most Arduinos have an on-board LED you can control. On the UNO, MEGA and ZERO 
  it is attached to digital pin 13, on MKR1000 on pin 6. LED_BUILTIN is set to
  the correct LED pin independent of which board is used.
  If you want to know what pin the on-board LED is connected to on your Arduino model, check
  the Technical Specs of your board  at https://www.arduino.cc/en/Main/Products
  
  This example code is in the public domain.

  modified 8 May 2014
  by Scott Fitzgerald
  
  modified 2 Sep 2016
  by Arturo Guadalupi
  
  modified 8 Sep 2016
  by Colby Newman

  modified 12 Mar 2021
  by Dave Eslinger: Name change for GoSciTech robotics camp
                    and a second delay for long-short blinking.
*/


// the setup function runs once when you press reset or power the board
void setup() {
  // initialize digital pin LED_BUILTIN as an output.
  pinMode(LED_BUILTIN, OUTPUT);
}

// the loop function runs over and over again forever
void loop() {
  int DelayTime = 1000;
  int DelayTime2 = 500;
  // int DelayTime =  random(10, 1000);
  digitalWrite(LED_BUILTIN, HIGH);   // turn the LED on (HIGH is the voltage level)
  delay(DelayTime);                       // wait for a second
  digitalWrite(LED_BUILTIN, LOW);    // turn the LED off by making the voltage LOW
  delay(DelayTime);                       // wait for a second

  digitalWrite(LED_BUILTIN, HIGH); 
  delay(DelayTime2); 
  digitalWrite(LED_BUILTIN, LOW); 
  delay(DelayTime2);
}
