OldFORTRANdog/GST_Arduino_Robotics/(commit log)

2021-03-11 Creating distribution dirctory, will move all source into it.
    [OdometryTrails.ods]
2021-03-11 2016 2nd week: week 4
    [OdometryTrails.ods]
2021-03-12 2017 second week, week 3
    [OdometryTrials.xls]
2021-03-12 2018 first session, week 1
    [DistanceTrials.xlsx, OdometryTrials.xls]
2021-03-12 2018 Second session, GST Week 4
    [DistanceTrials.xlsx, OdometryTrials.xls]
2021-03-12 2019 first session, GST week 2
    [DistanceTrials.xlsx]
2021-03-12 2019 session 2, GST week 3
    [DistanceTrials.xlsx]
2021-06-19 Adding centering program for servos
2021-07-06 Updated documentation to 2021 wiring graphics
    [B3_BlinkBumpLightIRSonicServos2021.fzz]
2021-07-06 Added bump controls where missing
    [B3_06_SpinSquare.ino, B3_07_Light.ino, B3_09B_Servo_Sonic.ino]
2022-06-20 Modified for 2022 with 12-V holder and no tilt servo.
2023-05-17 Move hole sand add 9-Volt battery pack
2023-05-17 Updated bottom chassis view
2023-07-05 Revisions and reorg after 2023 GoSciTech
    [B3_BlinkBumpLightIRSonicServos2021.fzz, B3_BlinkBumpLightIRSonicServos2024.fzz]
2023-07-06 Updated SVG images with new holes locations
2023-07-06 Updated wiring diagrams and layout for 2024
    Changes made after teaching in 2023. Should make a smoother build, if only I can get campers to pay attention to the instructions.
    [B3_BlinkBumpLightIRSonicServos2024.fzz]
2023-07-07 Updated code for new wiring post GoSciTech 2023 season.
2023-07-14 Remove wire.h; multitasking program
2023-07-21 Change print statements
2023-07-22 Fixed omni direction problem
    With change in B3 wiring of back motor to port 2, the X-axis direction shifted to FORWARD to the left, negative in the B3 coordinate system. Needed some sign changes to fix that.
    [B3_10_Holosquare.ino, B3_Multitasking.ino, BreadBoardBot-DISTRO.h]
2023-07-22 Adding SpinTest and needed supplementary changes
    [DistanceTrials.xlsx]
2023-07-23 ospin coding
    [DistanceTrials.xlsx]
2023-07-31 adding spin calibration code
    [DistanceTrials.xlsx]
2023-08-07 New wiring
    [B3_BlinkBumpLightIRSonicServos2024.fzz, DistanceTrials.xlsx]
2023-08-14 Update with new wiring
    [B3_BlinkBumpLightIRSonicServos2024.fzz]
2024-05-29 minor wire color changes
2024-06-04 Swap red and black power lines to motor
2024-06-04 Swap wires updated documentation
2025-06-18 Add wheel speed adjustable parameter to BreadBoardBot-DISTRO.h
